gonzacarv/Casandra/README.md

Casandra v1.3 - v8.2 (CocinaBis + Huerta v2)
Casandra v1.1 - v8.1 (NewServer)
Casandra v1.0 - v7.1 (BoolDebug)
Casandra v1.0 - v6 (RGB Add - Botones)    
Casandra v1.0 - v4 (TreinBuff fix)   
Firmwares de domótica personal (MCU: 18F4620, 16F877A, 16F628, Atmega328, Atmega2560, ESP8266).
