gonzacarv/Casandra/Hard/Proyecto CASANDRA.docx

Proyecto CASANDRA

Mapa de pines I/O:

I01 → RC0

I02 → RC1

I03 → RC2

I04 → RC3

I05 → RD0

I06 → RD1

I07 → +Vcc

I08 → RD6

I09 → RD5

I10 → RD4

I11 → RC4

I12 → RD3

I13 → RD2

I14 → +Vcc

O01 → RB6

O02 → RB5

O03 → RB4

O04 → RB3

O05 → RB2

O06 → RB1

O07 → GND

O08 → RB7

O09 → RA0

O10 → RA1

O11 → RA2

O12 → RA3

O13 → RA4

O14 → GND
