gonzacarv/Casandra/Hard/Actuador Entrada - Salida/Casandra v1PCB.BMP

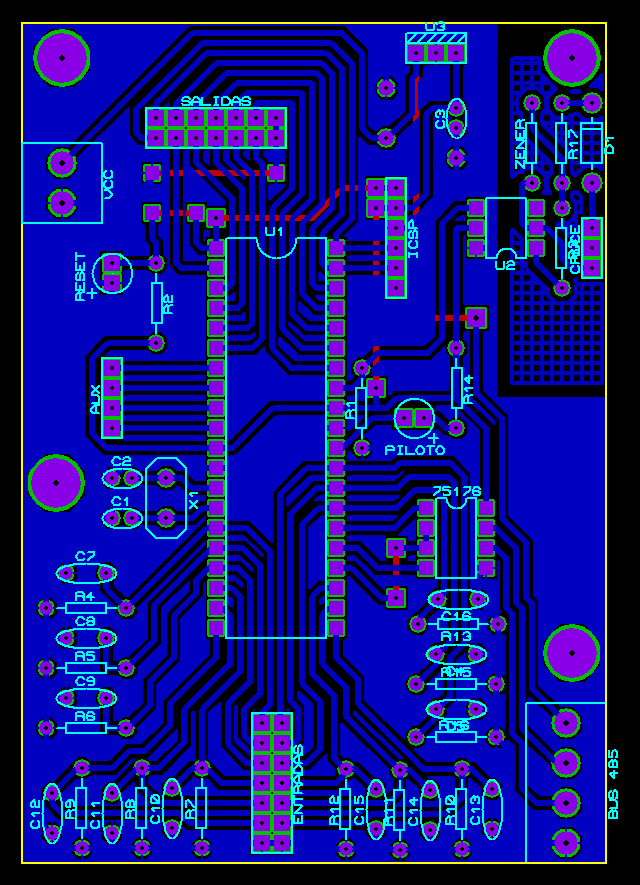
Hard/Actuador Entrada - Salida/Casandra v1PCB.BMP
