gonzacarv/Casandra/Hard/Actuador PotenciaPCB.BMP

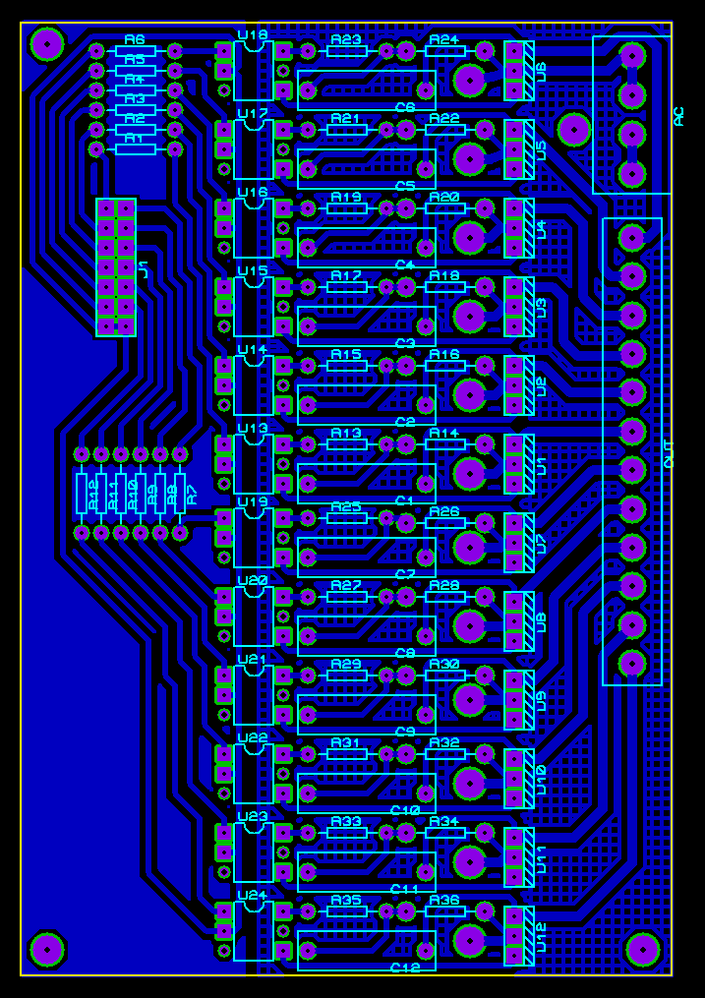
Hard/Actuador PotenciaPCB.BMP
