gonzacarv/Casandra/Hard/Entradas.BMP

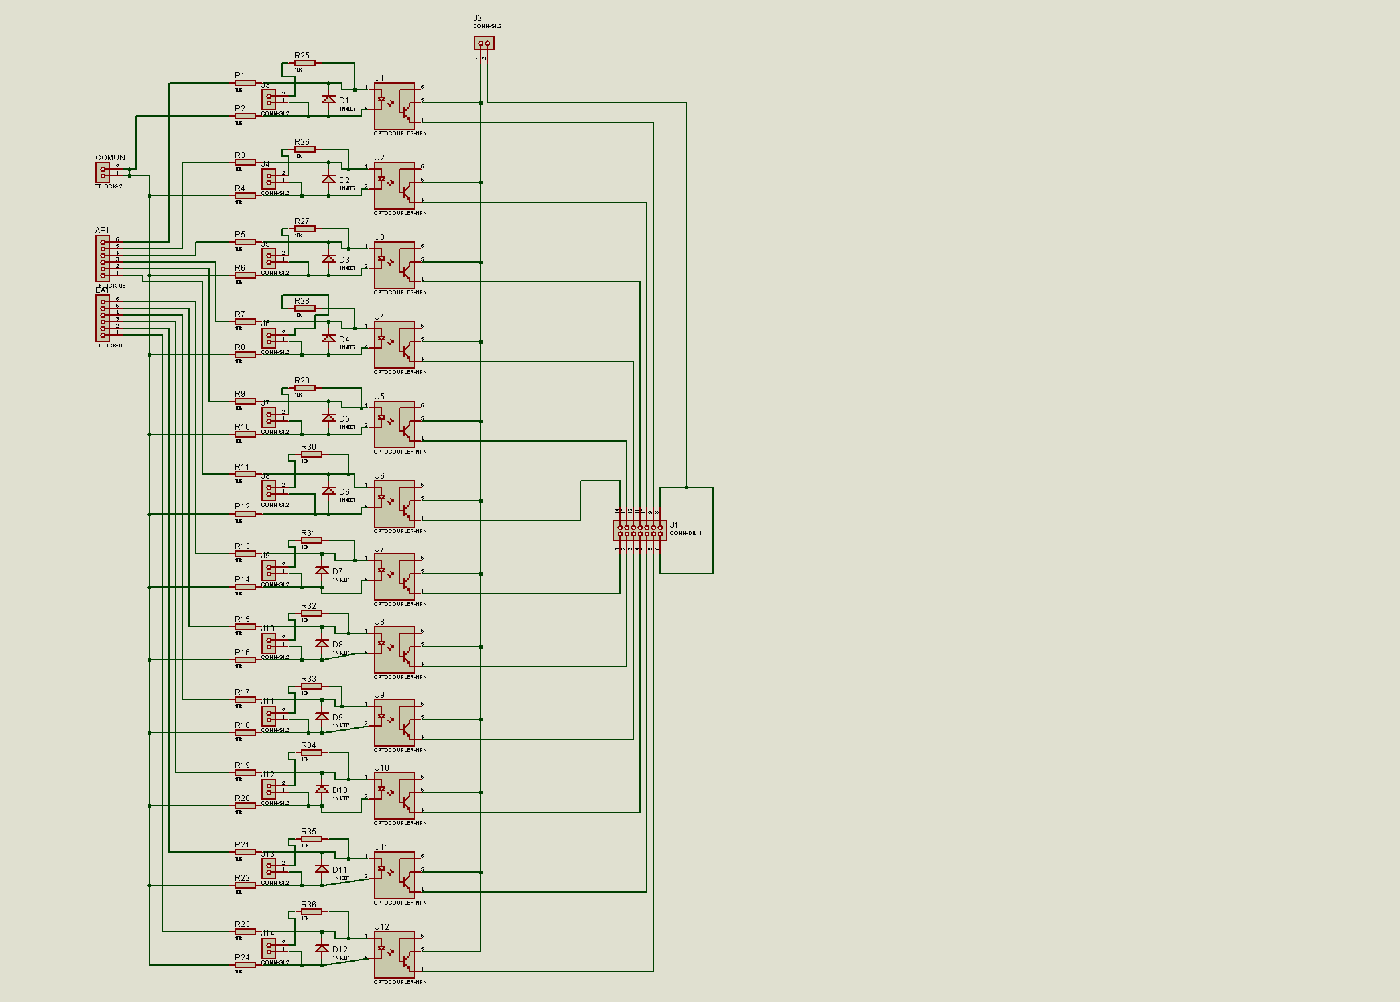
Hard/Entradas.BMP
