gonzacarv/Casandra/Hard/EntradasPCB.BMP

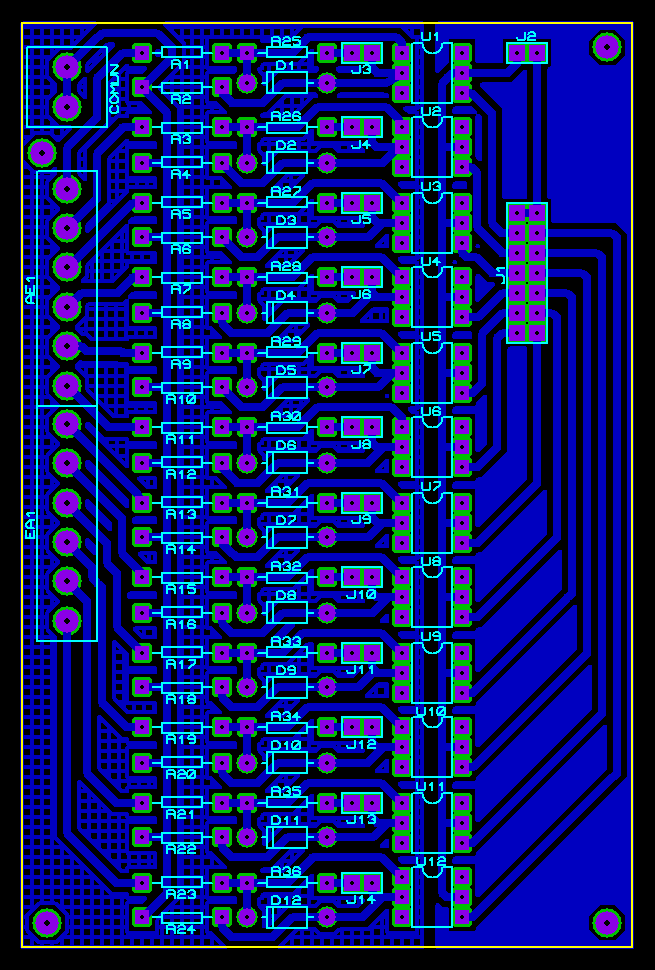
Hard/EntradasPCB.BMP
