gonzacarv/Casandra/Hard/Hardware/ENC28j60.png

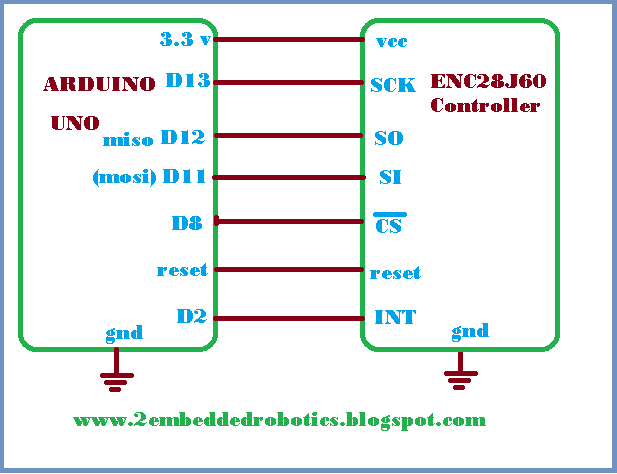
Hard/Hardware/ENC28j60.png
