gonzacarv/Casandra/Hard/Teclado/circuito.gif

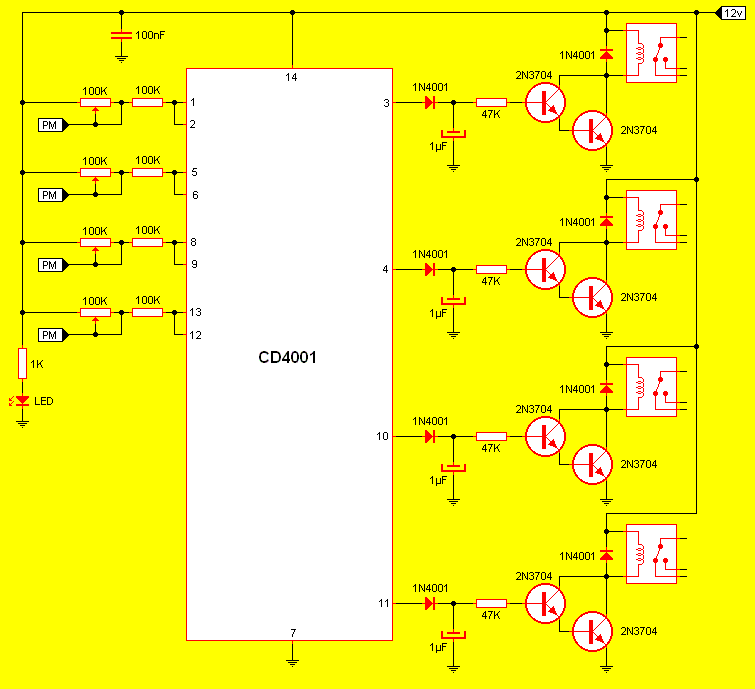
Hard/Teclado/circuito.gif
