gonzacarv/Casandra/Soft/Dimer.xlsx

Sheet: Comandos
 |  | Destinos |  |  | Comandos |  |  | COMANDOS EN RED
 |  | RED | LOCAL | checksum | Codigo | Descripcion |  | Byte (1): Ctrl | Byte (2): Destino |  | Byte (3): Comando |  | Byte (4): Checksum
 |  | 30 | ID |  | 27 | 10% |  |  | Valor | Descripcion | Valor | Descripcion
1 | 32 | 33 | 1 | 217 | 24 | 20% |  | 250 | 29 | PANICO | 29 | PANICO | Destino + Comando
2 |  | 34 | 2 | 216 | 21 | 30% |  | 250 | 33 a 93 | Luces individuales | 27 a 0 // 80 a 141 | Intensidad // Modos | Destino + Comando
3 |  | 35 | 3 | 215 | 18 | 40% |  | 250 | 100 | Todas las luces | 27 a 0 // 80 a 141 | Intensidad // Modos | Destino + Comando
4 |  | 36 | 4 | 214 | 15 | 50% |  | 250 | 150 | Webserver | 80: Off // 90: On | Off // On | Destino + Comando
5 |  | 37 | 5 | 213 | 12 | 60% |  | 250 | 151 | Telefonico | 80: Off // 90: On | Off // On | Destino + Comando
6 |  | 38 | 6 | 212 | 9 | 70% |  | 250 | 155 | Sirena | 0: Off // 1 ~ 99: Seg // 100: On | Off // Segundos // On | Destino + Comando
7 |  | 39 | 7 | 211 | 6 | 80% |  | 250 | 160 | Temperatura exterior | Codificado segun Programa | Ver codigo | Destino + Comando
8 |  | 40 | 8 | 210 | 3 | 90% |  | 250 | 165 | Intensidad del sol | Codificado segun Programa | Ver codigo | Destino + Comando
9 |  | 41 | 9 | 209 | 0 | 100% |  | 250 | 163 | Tension de bateria | Codificado segun Programa | Ver codigo | Destino + Comando
10 |  | 42 | 10 | 208 | … | … |  | 250 | 164 | Valor de jumper | Codificado segun Programa | Ver codigo | Destino + Comando
11 |  | 43 | 11 | 207 | 80 | Apagado |  | 250 | 184 | Identificacion de modulos | 49, 50, 51, 52 53 y 54 respectiv. | Mod 1 a 5 y mod exterior | Destino + Comando
12 |  | 44 | 12 | 206 | 90 | Encendido según int
13 | 44 | 45 | 1 | 205 | 102 | Encendido Fijo 1 | Max
14 |  | 46 | 2 | 204 | 95 | Encendido Fijo 2 | Med
15 |  | 47 | 3 | 203 | 96 | Encendido Fijo 3 | Bajo
16 |  | 48 | 4 | 202 | … | …
17 |  | 49 | 5 | 201 | 120 | ONOFF 2,56
18 |  | 50 | 6 | 200 | 121 | ONOFF 1,28
19 |  | 51 | 7 | 199 | 122 | ONOFF 0,64
20 |  | 52 | 8 | 198 | 123 | ONOFF 0,32
21 |  | 53 | 9 | 197 | … | …
22 |  | 54 | 10 | 196 | 130 | OLA 2,56
23 |  | 55 | 11 | 195 | 131 | OLA 1,28
24 |  | 56 | 12 | 194 | 132 | OLA 0,64
25 | 56 | 57 | 1 | 193 | … | …
26 |  | 58 | 2 | 192 | 140 | ALARMA ON 0,65
27 |  | 59 | 3 | 191 | 141 | ALARMA OFF
28 |  | 60 | 4 | 190
29 |  | 61 | 5 | 189
30 |  | 62 | 6 | 188 | ID's | 1: Cuartos 1
31 |  | 63 | 7 | 187 | ID's | 2: Cuartos 2
32 |  | 64 | 8 | 186 | ID's | 3: Cocina 1
33 |  | 65 | 9 | 185 | ID's | 4: Cocina 2
34 |  | 66 | 10 | 184 | ID's | 5: Galeria
35 |  | 67 | 11 | 183 | ID's | 6: Alarma
36 |  | 68 | 12 | 182 | ID's | 7: Web
37 | 68 | 69 | 1 | 181 | ID's | 8: Telefonico
38 |  | 70 | 2 | 180
39 |  | 71 | 3 | 179
40 |  | 72 | 4 | 178
41 |  | 73 | 5 | 177
42 |  | 74 | 6 | 176
43 |  | 75 | 7 | 175
44 |  | 76 | 8 | 174
45 |  | 77 | 9 | 173
46 |  | 78 | 10 | 172
47 |  | 79 | 11 | 171
48 |  | 80 | 12 | 170
49 | 80 | 81 | 1 | 169
50 |  | 82 | 2 | 168
51 |  | 83 | 3 | 167
52 |  | 84 | 4 | 166
53 |  | 85 | 5 | 165
54 |  | 86 | 6 | 164
55 |  | 87 | 7 | 163
56 |  | 88 | 8 | 162
57 |  | 89 | 9 | 161
58 |  | 90 | 10 | 160
59 |  | 91 | 11 | 159
60 |  | 92 | 12 | 158
 |  | 93 | Exterior | 157
 |  | 100 | TODOS
 |  | 150 | WEBServer | 80 | Apagado
 |  |  |  | 90 | Encendido
 |  | 151 | Telefonico | 80 | Apagado
 |  |  |  | 90 | Encendido
 |  | 155 | Sirena | TiempoSeg | 100 | ALARMA ON (sin teclas)
 |  |  |  |  | 0 | ALARMA OFF (recupera teclas)
 |  | 160 | TempOut | (se envia elevado +10 para evitar negativo en red)
 |  | 165 | LuzOut | (0 a 100 - no cumple checksum en 85%)
 |  | 163 | Vbat | x10 | y fuente
 |  | 164 | Jumper | (0 - 1)

Sheet: I-O
En MQTT | En RS485 | Salida PIC | Descripcion |  | Descripcion |  | IP | Mosquito
1 | 33 | 1 |  |  |  |  | 176 | Cuartos
2 | 34 | 2 | Luz Derecha Sofia |  | Interruptor Derecha Sofia |  | 71 | Cocina
3 | 35 | 3 | Luz Izquierda Sofia |  | Interruptor Izquierda Sofia |  | 128 | Galeria
4 | 36 | 4 | Luz principal Sofia |  | Interruptor principal Sofia |  | 76 | Caldera
5 | 37 | 5 |  |  |  |  | 77 | Hall
6 | 38 | 6 | Luz Izquierda Mama |  | Interruptor Izquierda Mama |  | 130 | Porton
7 | 39 | 7 | Luz Derecha Papa |  | Interruptor Derecha Papa |  | 146 | Estar
8 | 40 | 8 | Luz Vestidor Papa-Mama |  | Interruptor Vestidor Papa-Mama |  | 178 | CocinaBis
9 | 41 | 9 | Luz baño Papa-Mama |  | Interruptor baño Papa-Mama
10 | 42 | 10 | Luz Ante-baño Papa-Mama |  | Interruptor Ante-baño Papa-Mama
11 | 43 | 11 | Luz Perimetro |  | PANICO
12 | 44 | 12 | Luz Cuarto Papa-Mama |  | Interruptor Cuarto Papa-Mama
13 | 45 | 13 | Luz Ante-baño Sofia y Nico |  | Interruptor Ante-baño Sofia y Nico
14 | 46 | 14 | Luz Baño Sofia y Nico |  | Interruptor Baño Sofia y Nico
15 | 47 | 15 | Luz Pasillo Entrada/Estar |  | Interruptor Pasillo Entrada/Estar
16 | 48 | 16 | Luz Pasillo Cuartos |  | Interruptor Pasillo Cuartos
17 | 49 | 17 | Luz Cuarto Nico-Gon |  | Interruptor Cuarto Nico-Gon
18 | 50 | 18
19 | 51 | 19 | Luz Izquierda Nico |  | Interruptor Izquierda Nico
20 | 52 | 20 | Luz pasillito Cuarto Nico-Sofia |  | Interruptor pasillito Cuarto Nico-Sofia
21 | 53 | 21 | Luz Derecha Gon |  | Interruptor Derecha Gon
22 | 54 | 22
23 | 55 | 23
24 | 56 | 24 | Luz ventana del Hall |  | Interruptor ventana del Hall
1 | 57 | 25 | Luz Exterior entrada Principal
2 | 58 | 26 | Luz Hall | ok | Interruptor Hall | ok
3 | 59 | 27 |  |  | Hall | ok
4 | 60 | 28 |  |  | Sensor del Estar | ok
5 | 61 | 29 |  |  | Sensor de Cocina | ok
6 | 62 | 30 |  |  | Sensor del Living | ok
7 | 63 | 31 | Luz Central Cocina | ok | Interruptor Central Cocina | ok
8 | 64 | 32 | Luz Lavadero | ok | Interruptor Lavadero | ok
9 | 65 | 33 | Luz Estar | ok | Interruptor Estar | ok
10 | 66 | 34
11 | 67 | 35
12 | 68 | 36 | Luz Exterior Estar | ok | Interruptor Exterior Estar | ok
13 | 69 | 37
14 | 70 | 38 | Luz Living | ok | Interruptor living | ok
15 | 71 | 39
16 | 72 | 40 | Ventilador Estar
17 | 73 | 41 |  |  | Sensor del Pasillo del Lavadero | ok | IP | Mosquito
18 | 74 | 42 |  |  | Sensor del Garage | ok | 62 | Cuartos
19 | 75 | 43 | Luz Garage |  | Interruptor Garage | ok | 71 | Cocina
20 | 76 | 44 | Luz Pasillo Lavadero | ok | Interruptor Pasillo Lavadero | ok | 128 | Galeria
21 | 77 | 45 | Luz Toilette | ok | Interruptor Toilette | ok | 76 | Caldera
22 | 78 | 46 |  |  |  |  | 77 | Hall
23 | 79 | 47 |  |  |  |  | 130 | Porton
24 | 80 | 48 |  |  | Interruptor Comedor | ok | 146 | Estar
1 | 81 | 49 | Luz parrilla |  | Interruptor lado parrilla
2 | 82 | 50 | Luz zona parrilla |  | Interruptor C4
3 | 83 | 51 | Luz pared Galeria |  | Interruptor C1
4 | 84 | 52 | Luz Principal Galeria |  | Interruptor C3
5 | 85 | 53 | Ventilador Galeria |  | Interruptor C2
6 | 86 | 54 | Guirnalda Galeria
7 | 87 | 55
8 | 88 | 56 | Led Cobertizo
9 | 89 | 57
10 | 90 | 58
11 | 91 | 59 |  |  | Sensor de la Galeria
12 | 92 | 60 |  |  | Sensor de la Parrilla
1 | NA | 61 | Luz de sodio del jardin

Sheet: Red MQTT
N0 | N1 | N2 | N3 | Rango Payload | Descripcion | Ejecutor | Topic completo
Casandra | Cuartos | LuzEstado | 01 | 0 o 1 | Estado de encendido de luz | PIC | Casandra/Cuartos/LuzEstado/01
Casandra | Cuartos | LuzEstado | 02 | 0 o 1 | Estado de encendido de luz | PIC | Casandra/Cuartos/LuzEstado/02
Casandra | Cuartos | LuzEstado | 03 | 0 o 1 | Estado de encendido de luz | PIC | Casandra/Cuartos/LuzEstado/03
Casandra | Cuartos | LuzEstado | 04 | 0 o 1 | Estado de encendido de luz | PIC | Casandra/Cuartos/LuzEstado/04
Casandra | Cuartos | LuzEstado | 05 | 0 o 1 | Estado de encendido de luz | PIC | Casandra/Cuartos/LuzEstado/05
Casandra | Cuartos | LuzEstado | 06 | 0 o 1 | Estado de encendido de luz | PIC | Casandra/Cuartos/LuzEstado/06
Casandra | Cuartos | LuzEstado | 07 | 0 o 1 | Estado de encendido de luz | PIC | Casandra/Cuartos/LuzEstado/07
Casandra | Cuartos | LuzEstado | 08 | 0 o 1 | Estado de encendido de luz | PIC | Casandra/Cuartos/LuzEstado/08
Casandra | Cuartos | LuzEstado | 09 | 0 o 1 | Estado de encendido de luz | PIC | Casandra/Cuartos/LuzEstado/09
Casandra | Cuartos | LuzEstado | 10 | 0 o 1 | Estado de encendido de luz | PIC | Casandra/Cuartos/LuzEstado/10
Casandra | Cuartos | LuzEstado | 11 | 0 o 1 | Estado de encendido de luz | PIC | Casandra/Cuartos/LuzEstado/11
Casandra | Cuartos | LuzEstado | 12 | 0 o 1 | Estado de encendido de luz | PIC | Casandra/Cuartos/LuzEstado/12
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
Casandra | Cuartos | Temperatura | 01 | SignedInt | Temperatura en °C | NodeMCU | Casandra/Cuartos/Temperatura/01
Casandra | Cuartos | Temperatura | 02 | SignedInt | Temperatura en °C | NodeMCU | Casandra/Cuartos/Temperatura/02
Casandra | Cuartos | Humedad | 01 | SignedInt | Humedad porcentual | NodeMCU | Casandra/Cuartos/Humedad/01
Casandra | Cuartos | Humedad | 02 | SignedInt | Humedad porcentual | NodeMCU | Casandra/Cuartos/Humedad/02
Casandra | Cuartos | SensorMov | 01 | 0 o 1 | Estado de sensor de movimiento | NodeMCU | Casandra/Cuartos/SensorMov/01
Casandra | Cuartos | SensorMov | 02 | 1 o 1 | Estado de sensor de movimiento | NodeMCU | Casandra/Cuartos/SensorMov/02
Casandra | Cuartos | Mosquito |  | Reset / Reconect / Exec | Estado de reset del Mosquito Cuartos | NodeMCU | Casandra/Cuartos/Mosquito
Casandra | Cuartos | Modulo | 1 | on o off | Estado de reset del modulo | PIC | Casandra/Cuartos/Modulo/1
Casandra | Cuartos | Modulo | 2 | on o off | Estado de reset del modulo | PIC | Casandra/Cuartos/Modulo/2
Casandra | Cocina | LuzEstado | 01 | 0 o 1 | Estado de encendido de luz | PIC | Casandra/Cocina/LuzEstado/01
Casandra | Cocina | LuzEstado | 02 | 0 o 1 | Estado de encendido de luz | PIC | Casandra/Cocina/LuzEstado/02
Casandra | Cocina | LuzEstado | 03 | 0 o 1 | Estado de encendido de luz | PIC | Casandra/Cocina/LuzEstado/03
Casandra | Cocina | LuzEstado | 04 | 0 o 1 | Estado de encendido de luz | PIC | Casandra/Cocina/LuzEstado/04
Casandra | Cocina | LuzEstado | 05 | 0 o 1 | Estado de encendido de luz | PIC | Casandra/Cocina/LuzEstado/05
Casandra | Cocina | LuzEstado | 06 | 0 o 1 | Estado de encendido de luz | PIC | Casandra/Cocina/LuzEstado/06
Casandra | Cocina | LuzEstado | 07 | 0 o 1 | Estado de encendido de luz | PIC | Casandra/Cocina/LuzEstado/07
Casandra | Cocina | LuzEstado | 08 | 0 o 1 | Estado de encendido de luz | PIC | Casandra/Cocina/LuzEstado/08
Casandra | Cocina | LuzEstado | 09 | 0 o 1 | Estado de encendido de luz | PIC | Casandra/Cocina/LuzEstado/09
Casandra | Cocina | LuzEstado | 10 | 0 o 1 | Estado de encendido de luz | PIC | Casandra/Cocina/LuzEstado/10
Casandra | Cocina | LuzEstado | 11 | 0 o 1 | Estado de encendido de luz | PIC | Casandra/Cocina/LuzEstado/11
Casandra | Cocina | LuzEstado | 12 | 0 o 1 | Estado de encendido de luz | PIC | Casandra/Cocina/LuzEstado/12
Casandra | Cocina | LuzEstado | 13 | 0 o 1 | Estado de encendido de luz | PIC | Casandra/Cocina/LuzEstado/13
Casandra | Cocina | LuzEstado | 14 | 0 o 1 | Estado de encendido de luz | PIC | Casandra/Cocina/LuzEstado/14
Casandra | Cocina | LuzEstado | 15 | 0 o 1 | Estado de encendido de luz | PIC | Casandra/Cocina/LuzEstado/15
Casandra | Cocina | LuzEstado | 16 | 0 o 1 | Estado de encendido de luz | PIC | Casandra/Cocina/LuzEstado/16
Casandra | Cocina | LuzEstado | 17 | 0 o 1 | Estado de encendido de luz | PIC | Casandra/Cocina/LuzEstado/17
Casandra | Cocina | LuzEstado | 18 | 0 o 1 | Estado de encendido de luz | PIC | Casandra/Cocina/LuzEstado/18
Casandra | Cocina | LuzEstado | 19 | 0 o 1 | Estado de encendido de luz | PIC | Casandra/Cocina/LuzEstado/19
Casandra | Cocina | LuzEstado | 20 | 0 o 1 | Estado de encendido de luz | PIC | Casandra/Cocina/LuzEstado/20
Casandra | Cocina | LuzEstado | 21 | 0 o 1 | Estado de encendido de luz | PIC | Casandra/Cocina/LuzEstado/21
Casandra | Cocina | LuzEstado | 22 | 0 o 1 | Estado de encendido de luz | PIC | Casandra/Cocina/LuzEstado/22
Casandra | Cocina | LuzEstado | 23 | 0 o 1 | Estado de encendido de luz | PIC | Casandra/Cocina/LuzEstado/23
Casandra | Cocina | LuzEstado | 24 | 0 o 1 | Estado de encendido de luz | PIC | Casandra/Cocina/LuzEstado/24
Casandra | Cocina | LuzEstado | 25 | 0 o 1 | Estado de encendido de luz | NodeMCU | Casandra/Cocina/LuzEstado/25
Casandra | Cocina | LuzEstado | 26 | 0 o 1 | Estado de encendido de luz | NodeMCU | Casandra/Cocina/LuzEstado/26
Casandra | Cocina | LuzIntensidad | 01 | 0 a 100 | Intensidad de encendido de luz | PIC | Casandra/Cocina/LuzIntensidad/01
Casandra | Cocina | LuzIntensidad | 02 | 0 a 100 | Intensidad de encendido de luz | PIC | Casandra/Cocina/LuzIntensidad/02
Casandra | Cocina | LuzIntensidad | 03 | 0 a 100 | Intensidad de encendido de luz | PIC | Casandra/Cocina/LuzIntensidad/03
Casandra | Cocina | LuzIntensidad | 04 | 0 a 100 | Intensidad de encendido de luz | PIC | Casandra/Cocina/LuzIntensidad/04
Casandra | Cocina | LuzIntensidad | 05 | 0 a 100 | Intensidad de encendido de luz | PIC | Casandra/Cocina/LuzIntensidad/05
Casandra | Cocina | LuzIntensidad | 06 | 0 a 100 | Intensidad de encendido de luz | PIC | Casandra/Cocina/LuzIntensidad/06
Casandra | Cocina | LuzIntensidad | 07 | 0 a 100 | Intensidad de encendido de luz | PIC | Casandra/Cocina/LuzIntensidad/07
Casandra | Cocina | LuzIntensidad | 08 | 0 a 100 | Intensidad de encendido de luz | PIC | Casandra/Cocina/LuzIntensidad/08
Casandra | Cocina | LuzIntensidad | 09 | 0 a 100 | Intensidad de encendido de luz | PIC | Casandra/Cocina/LuzIntensidad/09
Casandra | Cocina | LuzIntensidad | 10 | 0 a 100 | Intensidad de encendido de luz | PIC | Casandra/Cocina/LuzIntensidad/10
Casandra | Cocina | LuzIntensidad | 11 | 0 a 100 | Intensidad de encendido de luz | PIC | Casandra/Cocina/LuzIntensidad/11
Casandra | Cocina | LuzIntensidad | 12 | 0 a 100 | Intensidad de encendido de luz | PIC | Casandra/Cocina/LuzIntensidad/12
Casandra | Cocina | LuzIntensidad | 13 | 0 a 100 | Intensidad de encendido de luz | PIC | Casandra/Cocina/LuzIntensidad/13
Casandra | Cocina | LuzIntensidad | 14 | 0 a 100 | Intensidad de encendido de luz | PIC | Casandra/Cocina/LuzIntensidad/14
Casandra | Cocina | LuzIntensidad | 15 | 0 a 100 | Intensidad de encendido de luz | PIC | Casandra/Cocina/LuzIntensidad/15
Casandra | Cocina | LuzIntensidad | 16 | 0 a 100 | Intensidad de encendido de luz | PIC | Casandra/Cocina/LuzIntensidad/16
Casandra | Cocina | LuzIntensidad | 17 | 0 a 100 | Intensidad de encendido de luz | PIC | Casandra/Cocina/LuzIntensidad/17
Casandra | Cocina | LuzIntensidad | 18 | 0 a 100 | Intensidad de encendido de luz | PIC | Casandra/Cocina/LuzIntensidad/18
Casandra | Cocina | LuzIntensidad | 19 | 0 a 100 | Intensidad de encendido de luz | PIC | Casandra/Cocina/LuzIntensidad/19
Casandra | Cocina | LuzIntensidad | 20 | 0 a 100 | Intensidad de encendido de luz | PIC | Casandra/Cocina/LuzIntensidad/20
Casandra | Cocina | LuzIntensidad | 21 | 0 a 100 | Intensidad de encendido de luz | PIC | Casandra/Cocina/LuzIntensidad/21
Casandra | Cocina | LuzIntensidad | 22 | 0 a 100 | Intensidad de encendido de luz | PIC | Casandra/Cocina/LuzIntensidad/22
Casandra | Cocina | LuzIntensidad | 23 | 0 a 100 | Intensidad de encendido de luz | PIC | Casandra/Cocina/LuzIntensidad/23
Casandra | Cocina | LuzIntensidad | 24 | 0 a 100 | Intensidad de encendido de luz | PIC | Casandra/Cocina/LuzIntensidad/24
Casandra | Cocina | Temperatura | 01 | SignedInt | Temperatura en °C | NodeMCU | Casandra/Cocina/Temperatura/01
Casandra | Cocina | Temperatura | 02 | SignedInt | Temperatura en °C | NodeMCU | Casandra/Cocina/Temperatura/02
Casandra | Cocina | Humedad | 01 | SignedInt | Humedad porcentual | NodeMCU | Casandra/Cocina/Humedad/01
Casandra | Cocina | Humedad | 02 | SignedInt | Humedad porcentual | NodeMCU | Casandra/Cocina/Humedad/02
Casandra | Cocina | SensorMov | 01 | 0 o 1 | Estado de sensor de movimiento | NodeMCU | Casandra/Cocina/SensorMov/01
Casandra | Cocina | SensorMov | 02 | 0 o 1 | Estado de sensor de movimiento | NodeMCU | Casandra/Cocina/SensorMov/02
Casandra | Cocina | SensorMov | 03 | 0 o 1 | Estado de sensor de movimiento | NodeMCU | Casandra/Cocina/SensorMov/03
Casandra | Cocina | SensorMov | 04 | 0 o 1 | Estado de sensor de movimiento | NodeMCU | Casandra/Cocina/SensorMov/04
Casandra | Cocina | SensorMov | 05 | 0 o 1 | Estado de sensor de movimiento | NodeMCU | Casandra/Cocina/SensorMov/05
Casandra | Cocina | SensorMov | 06 | 0 o 1 | Estado de sensor de movimiento | NodeMCU | Casandra/Cocina/SensorMov/06
Casandra | Cocina | Mosquito |  | Reset / Reconect / Exec | Estado de reset del Mosquito Cocina | NodeMCU | Casandra/Cocina/Mosquito
Casandra | Cocina | Modulo | 1 | on o off | Estado de reset del modulo | PIC | Casandra/Cocina/Modulo/1
Casandra | Cocina | Modulo | 2 | on o off | Estado de reset del modulo | PIC | Casandra/Cocina/Modulo/2
Casandra | Galeria | LuzEstado | 01 | 0 o 1 | Estado de encendido de luz | PIC | Casandra/Galeria/LuzEstado/01
Casandra | Galeria | LuzEstado | 02 | 0 o 1 | Estado de encendido de luz | PIC | Casandra/Galeria/LuzEstado/02
Casandra | Galeria | LuzEstado | 03 | 0 o 1 | Estado de encendido de luz | PIC | Casandra/Galeria/LuzEstado/03
Casandra | Galeria | LuzEstado | 04 | 0 o 1 | Estado de encendido de luz | PIC | Casandra/Galeria/LuzEstado/04
Casandra | Galeria | LuzEstado | 05 | 0 o 1 | Estado de encendido de luz | PIC | Casandra/Galeria/LuzEstado/05
Casandra | Galeria | LuzEstado | 06 | 0 o 1 | Estado de encendido de luz | PIC | Casandra/Galeria/LuzEstado/06
Casandra | Galeria | LuzEstado | 07 | 0 o 1 | Estado de encendido de luz | PIC | Casandra/Galeria/LuzEstado/07
Casandra | Galeria | LuzEstado | 08 | 0 o 1 | Estado de encendido de luz | PIC | Casandra/Galeria/LuzEstado/08
Casandra | Galeria | LuzEstado | 09 | 0 o 1 | Estado de encendido de luz | PIC | Casandra/Galeria/LuzEstado/09
Casandra | Galeria | LuzEstado | 10 | 0 o 1 | Estado de encendido de luz | PIC | Casandra/Galeria/LuzEstado/10
Casandra | Galeria | LuzEstado | 11 | 0 o 1 | Estado de encendido de luz | PIC | Casandra/Galeria/LuzEstado/11
Casandra | Galeria | LuzEstado | 12 | 0 o 1 | Estado de encendido de luz | PIC | Casandra/Galeria/LuzEstado/12
Casandra | Galeria | LuzIntensidad | 01 | 0 a 100 | Intensidad de encendido de luz | PIC | Casandra/Galeria/LuzIntensidad/01
Casandra | Galeria | LuzIntensidad | 02 | 0 a 100 | Intensidad de encendido de luz | PIC | Casandra/Galeria/LuzIntensidad/02
Casandra | Galeria | LuzIntensidad | 03 | 0 a 100 | Intensidad de encendido de luz | PIC | Casandra/Galeria/LuzIntensidad/03
Casandra | Galeria | LuzIntensidad | 04 | 0 a 100 | Intensidad de encendido de luz | PIC | Casandra/Galeria/LuzIntensidad/04
Casandra | Galeria | LuzIntensidad | 05 | 0 a 100 | Intensidad de encendido de luz | PIC | Casandra/Galeria/LuzIntensidad/05
Casandra | Galeria | LuzIntensidad | 06 | 0 a 100 | Intensidad de encendido de luz | PIC | Casandra/Galeria/LuzIntensidad/06
Casandra | Galeria | LuzIntensidad | 07 | 0 a 100 | Intensidad de encendido de luz | PIC | Casandra/Galeria/LuzIntensidad/07
Casandra | Galeria | LuzIntensidad | 08 | 0 a 100 | Intensidad de encendido de luz | PIC | Casandra/Galeria/LuzIntensidad/08
Casandra | Galeria | LuzIntensidad | 09 | 0 a 100 | Intensidad de encendido de luz | PIC | Casandra/Galeria/LuzIntensidad/09
Casandra | Galeria | LuzIntensidad | 10 | 0 a 100 | Intensidad de encendido de luz | PIC | Casandra/Galeria/LuzIntensidad/10
Casandra | Galeria | LuzIntensidad | 11 | 0 a 100 | Intensidad de encendido de luz | PIC | Casandra/Galeria/LuzIntensidad/11
Casandra | Galeria | LuzIntensidad | 12 | 0 a 100 | Intensidad de encendido de luz | PIC | Casandra/Galeria/LuzIntensidad/12
Casandra | Galeria | Temperatura | 01 | SignedInt | Temperatura en °C | NodeMCU | Casandra/Galeria/Temperatura/01
Casandra | Galeria | Temperatura | 02 | SignedInt | Temperatura en °C | NodeMCU | Casandra/Galeria/Temperatura/02
Casandra | Galeria | Humedad | 01 | SignedInt | Humedad porcentual | NodeMCU | Casandra/Galeria/Humedad/01
Casandra | Galeria | Humedad | 02 | SignedInt | Humedad porcentual | NodeMCU | Casandra/Galeria/Humedad/02
Casandra | Galeria | SensorMov | 01 | 0 o 1 | Estado de sensor de movimiento | NodeMCU | Casandra/Galeria/SensorMov/01
Casandra | Galeria | SensorMov | 02 | 1 o 1 | Estado de sensor de movimiento | NodeMCU | Casandra/Galeria/SensorMov/02
Casandra | Galeria | Mosquito |  | Reset / Reconect / Exec | Estado de reset del Mosquito Galeria | NodeMCU | Casandra/Galeria/Mosquito
Casandra | Galeria | Modulo | 1 | on o off | Estado de reset del modulo | PIC | Casandra/Galeria/Modulo/1
Casandra | Hall | Sodios |  | 0 o 1 | Estado de encendido de Sodios | NodeMCU | Casandra/Hall/Sodios
Casandra | Hall | Sirena |  | 0 a 5 | X:0000 ; 1:1111 ; 2:1000 ; 3:1010 ; 4:1100 ; 5:0111 | NodeMCU | Casandra/Hall/Sirena
Casandra | Hall | LuzCamino |  | 0 o 1 | Estado de encendido de Luz del camino de entrada | NodeMCU | Casandra/Hall/LuzCamino
Casandra | Hall | LuzEntrada |  | 0 o 1 | Estado de encendido de Luz entrada | NodeMCU | Casandra/Hall/LuzEntrada
Casandra | Hall | Porton |  | 0 o 1 o 2 | Estado del porton | NodeMCU | Casandra/Hall/Porton
Casandra | Hall | Timbre |  | 0 o 1 | Estado del pulsador del timbre | NodeMCU | Casandra/Hall/Timbre
Casandra | Hall | Mosquito |  | Reset / Reconect / Exec | Estado de reset del Mosquito Hall | NodeMCU | Casandra/Hall/Mosquito
Casandra | Caldera | LuzSolar |  | UnsignedInt | Intensidad porcentual del sol | NodeMCU | Casandra/Caldera/LuzSolar
Casandra | Caldera | Lluvia |  | 0 o 1 | Sensor de lluvia | NodeMCU | Casandra/Caldera/Lluvia
Casandra | Caldera | Temperatura |  | SignedInt | Temperatura en °C | NodeMCU | Casandra/Caldera/Temperatura
Casandra | Caldera | LuzEstado | 01 | 0 o 1 | Estado de encendido de luz | NodeMCU | Casandra/Caldera/LuzEstado/01
Casandra | Caldera | LuzEstado | 02 | 0 o 1 | Estado de encendido de luz | NodeMCU | Casandra/Caldera/LuzEstado/02
Casandra | Caldera | LuzEstado | 03 | 0 o 1 | Estado de encendido de luz | NodeMCU | Casandra/Caldera/LuzEstado/03
Casandra | Caldera | Termostato |  | 0 o 1 | Estado de encendido del termostato | NodeMCU | Casandra/Caldera/Termostato
Casandra | Caldera | SensorMov | 01 | 0 o 1 | Estado de sensor de movimiento | NodeMCU | Casandra/Caldera/SensorMov/01
Casandra | Caldera | SensorMov | 02 | 0 o 1 | Estado de sensor de movimiento | NodeMCU | Casandra/Caldera/SensorMov/02
Casandra | Caldera | Mosquito |  | Reset / Reconect / Exec | Estado de reset del Mosquito Caldera | NodeMCU | Casandra/Caldera/Mosquito
Casandra | Porton | BtnAbrir |  | "PRESS" | Se enciende por 250ms y se apaga solo (BC548) | NodeMCU | Casandra/Porton/BtnAbrir
Casandra | Porton | BtnCerrar |  | "PRESS" | Se enciende por 250ms y se apaga solo (BC548) | NodeMCU | Casandra/Porton/BtnCerrar
Casandra | Porton | LuzCamino |  | 0 o 1 | Activa Relé | NodeMCU | Casandra/Porton/LuzCamino
Casandra | Porton | Timbre |  | 0 o 1 | Sensor de timbre | NodeMCU | Casandra/Porton/Timbre
Casandra | Porton | SensPuerta |  | 0 o 1 | Sensor de puerta | NodeMCU | Casandra/Porton/SensPuerta
Casandra | Porton | SensPorton |  | 0 o 1 | Sensor de porton | NodeMCU | Casandra/Porton/SensPorton
Casandra | Porton | Mosquito |  | Reset / Reconect / Exec | Estado de reset del Mosquito Porton | NodeMCU | Casandra/Porton/Mosquito
Casandra | Estar | LuzRGB |  | byte1,byte2,byte3 | Colores de 0 a 255 secuencia R-G-B | NodeMCU | Casandra/Estar/LuzRGB
Casandra | Estar | LuzEstado |  | 0 o 1 | Estado de encendido de luz | NodeMCU | Casandra/Estar/LuzEstado
Casandra | Estar | ModoLED |  | 1, 2, 3. 4 y 5 | "Normal", "OlaRGB", "FlashRGB". "Respira", "Flash" | NodeMCU | Casandra/Estar/ModoLED
Casandra | Estar | VelocidadLED |  | 0 a 10 | Velocidad del modo de encendido | NodeMCU | Casandra/Estar/VelocidadLED
Casandra | Estar | LuzIntensidad |  | 0 a 100 | Intensidad de encendido de luz | NodeMCU | Casandra/Estar/LuzIntensidad
Casandra | Estar | Temperatura |  | SignedInt | Temperatura en °C | NodeMCU | Casandra/Estar/Temperatura
Casandra | Estar | Humedad |  | SignedInt | Humedad porcentual | NodeMCU | Casandra/Estar/Humedad
Casandra | Estar | Termostato |  | 0 o 1 | Estado de encendido del termostato | NodeMCU | Casandra/Estar/Termostato
Casandra | Estar | CRemoto | BtnOnTV | "PRESS" | Boton de encendido de TV | NodeMCU | Casandra/Estar/CRemoto/BtnOnTV
Casandra | Estar | CRemoto | BtnOnDeco | "PRESS" | Boton de encendido de Deco | NodeMCU | Casandra/Estar/CRemoto/BtnOnDeco
Casandra | Estar | CRemoto | BtnCanalUpDeco | "PRESS" | Subir canal Deco | NodeMCU | Casandra/Estar/CRemoto/BtnCanalUpDeco
Casandra | Estar | CRemoto | BtnCanalDoDeco | "PRESS" | Bajar canal Deco | NodeMCU | Casandra/Estar/CRemoto/BtnCanalDoDeco
Casandra | Estar | CRemoto | BtnVolUpDeco | "PRESS" | Subir volumen Deco | NodeMCU | Casandra/Estar/CRemoto/BtnVolUpDeco
Casandra | Estar | CRemoto | BtnVolDoDeco | "PRESS" | Bajar volumen Deco | NodeMCU | Casandra/Estar/CRemoto/BtnVolDoDeco
Casandra | Estar | CRemoto | DecoBtn0 | "PRESS" | Boton 0 deco Express | NodeMCU | Casandra/Estar/CRemoto/DecoBtn0
Casandra | Estar | CRemoto | DecoBtn1 | "PRESS" | Boton 1 deco Express | NodeMCU | Casandra/Estar/CRemoto/DecoBtn1
Casandra | Estar | CRemoto | DecoBtn2 | "PRESS" | Boton 2 deco Express | NodeMCU | Casandra/Estar/CRemoto/DecoBtn2
Casandra | Estar | CRemoto | DecoBtn3 | "PRESS" | Boton 3 deco Express | NodeMCU | Casandra/Estar/CRemoto/DecoBtn3
Casandra | Estar | CRemoto | DecoBtn4 | "PRESS" | Boton 4 deco Express | NodeMCU | Casandra/Estar/CRemoto/DecoBtn4
Casandra | Estar | CRemoto | DecoBtn5 | "PRESS" | Boton 5 deco Express | NodeMCU | Casandra/Estar/CRemoto/DecoBtn5
Casandra | Estar | CRemoto | DecoBtn6 | "PRESS" | Boton 6 deco Express | NodeMCU | Casandra/Estar/CRemoto/DecoBtn6
Casandra | Estar | CRemoto | DecoBtn7 | "PRESS" | Boton 7 deco Express | NodeMCU | Casandra/Estar/CRemoto/DecoBtn7
Casandra | Estar | CRemoto | DecoBtn8 | "PRESS" | Boton 8 deco Express | NodeMCU | Casandra/Estar/CRemoto/DecoBtn8
Casandra | Estar | CRemoto | DecoBtn9 | "PRESS" | Boton 9 deco Express | NodeMCU | Casandra/Estar/CRemoto/DecoBtn9
Casandra | Estar | CRemoto | DecoBtnOk | "PRESS" | Boton OK deco Express | NodeMCU | Casandra/Estar/CRemoto/DecoBtnOk
Casandra | Estar | CRemoto | DecoBtnUp | "PRESS" | Boton Arriba deco Express | NodeMCU | Casandra/Estar/CRemoto/DecoBtnUp
Casandra | Estar | CRemoto | DecoBtnDw | "PRESS" | Boton Abajo deco Express | NodeMCU | Casandra/Estar/CRemoto/DecoBtnDw
Casandra | Estar | CRemoto | DecoBtnDe | "PRESS" | Boton Derecha deco Express | NodeMCU | Casandra/Estar/CRemoto/DecoBtnDe
Casandra | Estar | CRemoto | DecoBtnIz | "PRESS" | Boton Izquierda deco Express | NodeMCU | Casandra/Estar/CRemoto/DecoBtnIz
Casandra | Estar | CRemoto | DecoBtnMute | "PRESS" | Boton Mute deco Express | NodeMCU | Casandra/Estar/CRemoto/DecoBtnMute
Casandra | Estar | CRemoto | DecoBtnGuide | "PRESS" | Boton Guide deco Express | NodeMCU | Casandra/Estar/CRemoto/DecoBtnGuide
Casandra | Estar | CRemoto | DecoBtnExit | "PRESS" | Boton Exit deco Express | NodeMCU | Casandra/Estar/CRemoto/DecoBtnExit
Casandra | Estar | AA | Fan | String | [“auto”, “low”, “medium”, “high”] | NodeMCU | Casandra/Estar/AA/Fan
Casandra | Estar | AA | Modo | String | [“auto”, “off”, “cool”, “heat”, “dry”, “fan_only”] | NodeMCU | Casandra/Estar/AA/Modo
Casandra | Estar | AA | Swing | String | [“on”, “off”] | NodeMCU | Casandra/Estar/AA/Swing
Casandra | Estar | AA | TempObj | 16 a 30 | Temperatura objetivo del aire | NodeMCU | Casandra/Estar/AA/TempObj
Casandra | Estar | Mosquito |  | Reset / Reconect / Exec | Estado de reset del Mosquito Estar | NodeMCU | Casandra/Estar/Mosquito
Casandra | Huerta | On |  | 3 a 5000 seg | Tiempo de prendido | NodeMCU | Casandra/Huerta/On
Casandra | Huerta | Off |  | 3 a 5000 seg | Tiempo de apagado | NodeMCU | Casandra/Huerta/Off
Casandra | Huerta | Bomba |  | 0 o 1 | Sensor de encendido de la bomba | NodeMCU | Casandra/Huerta/Bomba
Casandra | Huerta | BbaEstado |  | 0 o 1 | Comando de encendido de la bomba | NodeMCU | Casandra/Huerta/BbaEstado
Casandra | Huerta | Mosquito |  | Reset / Reconect / Exec | Estado de reset del Mosquito Huerta | NodeMCU | Casandra/Huerta/Mosquito
Casandra | CocinaBis | LEDMesadaEst |  | 0 o 1 | Estado de encendido de luz LED | NodeMCU | Casandra/CocinaBis/LEDMesadaEst
Casandra | CocinaBis | LEDMesadaInt |  | 0 a 100 | Intensidad de encendido de luz LED | NodeMCU | Casandra/CocinaBis/LEDMesadaInt
Casandra | CocinaBis | ModoLED |  | 1, 2 y 3 | "Normal", "Respira", "Flash" | NodeMCU | Casandra/CocinaBis/ModoLED
Casandra | CocinaBis | VelocidadLED |  | 0 a 100 | Velocidad del modo de encendido | NodeMCU | Casandra/CocinaBis/VelocidadLED
Casandra | CocinaBis | SWPorton |  | 0 o 1 | Estado de Switch Porton | NodeMCU | Casandra/CocinaBis/SWPorton
Casandra | CocinaBis | LuzEntrada |  | 0 o 1 | Estado de encendido de Luz entrada | NodeMCU | Casandra/CocinaBis/LuzEntrada
Casandra | CocinaBis | Mosquito |  | Reset / Reconect / Exec | Estado de reset del Mosquito CocinaBis | NodeMCU | Casandra/CocinaBis/Mosquito

Sheet: Sensor Luz v3
Valor Raw | F1 | F2 | F3 |  |  |  |  |  | Luz Intens | F1 | F2 |  |  |  |  | Luz Intens | F1 | F2 |  | x | y
0 | 0.0 |  |  |  | Elec | MQTT |  |  | 0 | -200 | 0 |  | Elec | MQTT |  | 0 | 0 | 23 | p1 | 200 | 50
10 | 3.3 |  |  |  | 700 | 50 |  |  | 10 | -197.06 | 0.59 |  | 0 | 0 |  | 10 | 2.5 | 23.95 | p2 | 655 | 100
20 | 6.7 |  |  |  | 110 | 34 | 0.3090909091 |  | 20 | -194.12 | 1.18 |  | 300 | 50 | 0.1666666667 | 20 | 5 | 24.9
30 | 10.0 |  |  | 580 | 690 | 49 | 0.08448275862 | 15 | 30 | -191.18 | 1.77 | 560 | 860 | 100 | 0.1785714286 | 30 | 7.5 | 25.85 | m | 0.1098901099
40 | 13.3 |  |  |  |  |  |  |  | 40 | -188.24 | 2.36 |  |  |  |  | 40 | 10 | 26.8
50 | 16.7 |  |  | 0.02586206897 | 0.02586206897 |  |  |  | 50 | -185.3 | 2.95 |  |  |  |  | 50 | 12.5 | 27.75
60 | 20.0 |  |  |  |  |  |  |  | 60 | -182.36 | 3.54 |  |  |  |  | 60 | 15 | 28.7
70 | 23.3 |  |  |  |  |  |  |  | 70 | -179.42 | 4.13 |  |  |  |  | 70 | 17.5 | 29.65
80 | 26.7 |  |  |  |  |  |  |  | 80 | -176.48 | 4.72 |  |  |  |  | 80 | 20 | 30.6
90 | 30.0 |  |  |  |  |  |  |  | 90 | -173.54 | 5.31 |  |  |  |  | 90 | 22.5 | 31.55
100 | 33.3 |  |  |  |  |  |  |  | 100 | -170.6 | 5.9 |  |  |  |  | 100 | 25 | 32.5
110 |  | 33.86 |  |  |  |  |  |  | 110 | -167.66 | 6.49 |  |  |  |  | 110 | 27.5 | 33.45
120 |  | 34.12 |  |  |  |  |  |  | 120 | -164.72 | 7.08 |  |  |  |  | 120 | 30 | 34.4
130 |  | 34.38 |  |  |  |  |  |  | 130 | -161.78 | 7.67 |  |  |  |  | 130 | 32.5 | 35.35
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
940 |  |  | 87.58 |  |  |  |  |  | 940 | 76.36 | 55.46 |  |  |  |  | 940 | 156.98 | 112.3
950 |  |  | 89.15 |  |  |  |  |  | 950 | 79.3 | 56.05 |  |  |  |  | 950 | 158.65 | 113.25
960 |  |  | 90.72 |  |  |  |  |  | 960 | 82.24 | 56.64 |  |  |  |  | 960 | 160.32 | 114.2
970 |  |  | 92.29 |  |  |  |  |  | 970 | 85.18 | 57.23 |  |  |  |  | 970 | 161.99 | 115.15
980 |  |  | 93.86 |  |  |  |  |  | 980 | 88.12 | 57.82 |  |  |  |  | 980 | 163.66 | 116.1
990 |  |  | 95.43 |  |  |  |  |  | 990 | 165.33 | 117.05
1000 |  |  | 97.00 |  |  |  |  |  | 1000 | 167 | 118
1010 |  |  | 98.57 |  |  |  |  |  | 1010 | 168.67 | 118.95
1020 |  |  | 100.14 |  |  |  |  |  | 1020 | 170.34 | 119.9
1024 |  |  | 100.77

Sheet: MapeoIR
BtnOnTV | 0x20DF10EF
BtnOnDeco | 0x10110EF
BtnCanalUpDeco | 0x101926D
BtnCanalDoDeco | 0x10112ED
BtnVolUpDeco | 0x101906F
BtnVolDoDeco | 0x10150AF
DecoBtn0 | 0x1017887
DecoBtn1 | 0x101C03F
DecoBtn2 | 0x101C837
DecoBtn3 | 0x101D827
DecoBtn4 | 0x10120DF
DecoBtn5 | 0x10128D7
DecoBtn6 | 0x10138C7
DecoBtn7 | 0x101A05F
DecoBtn8 | 0x101A857
DecoBtn9 | 0x101B847
DecoBtnOK | 0x101F00F
DecoBtnUp | 0x101609F
DecoBtnDw | 0x101E01F
DecoBtnDe | 0x101E817
DecoBtnIz | 0x101708F
DecoBtnMute | 0x10158A7
DecoBtnGuide | 0x1018877
DecoBtnExit | 0x101E41B

Sheet: ZeroCross
Porcentaje | Valor Byte
10% | 27 | Valor Byte | Porcentaje | 0 | 1 | de | 0 | si max 100 |  | Resp
20% | 24 | 0 |  | 255 |  | hasta | 255 | 0 | 25 | de 0 a 25 | max | mantiene max
30% | 21 | 3 | 90% | 256 | 2 | de | 0 | 25 | 125 | de 25 a Max+25 | --max | llega a 0
40% | 18 | 7 |  | 511 |  | hasta | 255 | 125 | 150 | de max+25 a max+50 | 0 | mantiene 0
50% | 15 | 11 |  | 512 | 3 | de | 0 | 150 | 250 | de max+50 a 2max+50 | ++max | llega a max
60% | 12 | 15 | 50% | 767 |  | hasta | 255 |  | 251 = 0
70% | 9 | 19 |  | 768 | 4 | de | 0
80% | 6 | 23 |  | 1023 |  | hasta | 255
90% | 3 | 27 | 10% | 1024 | 5 | de | 0
100% | 0 | 31 |  | 1279 |  | hasta | 255
0% | 95 | 35 | Apago (34) | 1280 | 6 | de | 0
 |  | 39 |  | 1535 |  | hasta | 255
 |  | 43 | 90% | 1536 |  | vuelve a | 0
 |  | 47
 |  | 51
 |  | 55 | 50%
 |  | 59
 |  | 63
 |  | 67 | 10%
 |  | 71
 |  | 75 | Apago (74)

Sheet: Sensor de Luz 2 (obsoleto)
Momento | Valor | Valor real
Oscuridad total | 181 | 724 | 1 | 724 | 1 | 724 | 1
Umbral Optimo | 80 | 320 | 50 | 320 | 60 | 52 | 94
Tarde adentrada (50%) |  | 0 |  | 52 | 94
Sol total | 13 | 52 | 94

Sheet: Sensores (obsoleto)
 | Luz | V | Fuente | Bateria | °C | Lm35 | Jumper
200 | 100 | 0.5 | 17 | 17 | 158 | 5 | OK | 0
220 | 75 | 1 | 35 | 35 | 165 | 7 | Ausente | >10
280 | 30 | 2 | 73 | 73 | 186 | 17
380 | 10 | 3 | 109 | 109 | 205 | 26
680 | 3 | 3.2 | 117 | 117 | 231 | 38
 |  |  |  |  | 236 | 41
 |  |  |  |  | 247 | 45

Sheet: Menu (obsoleto)
Valor | Vision | EstadoAl (bits) | Alarma | Significado | ConfCas (bits) | Casandra | Significado
0 | Apagado | 1 | Desactivada | Normal - Alarma apagada | 0 | Pasillos | Habilita servicios de pasillo
Hold desde 0 | Casandra HOLA :) | 2 (121) | Activada pasiva 1 | Activa total sin disparar | 1 | Automatico 1 | Habilita automatico 1
1 | Resumen principal | 3 (122) | Activada pasiva 2 | Activa fuera de cuartos sin disparar | 2 | Automatico 2 | Habilita automatico 2
2 | Menu - Activar Alarma | 4 (123) | Activada pasiva 3 | Activa en exterior sin disparar | 3 | Automatico 3 | Habilita automatico 3
3 | Menu - Luces | 5 | Prepanico | Disparada en etapa sin sonido | 4 | Automatico 4 | Habilita automatico 4
4 | Menu - Casandra | 6 | Prepanico | Disparada en etapa sonido intermitente | 5 | Modulo Web | Habilita modulo web
5 | Menu - Grupo automatico | 7 | Panico | Disparo total
6 | Menu - Configuracion | 8 | ¿Armandose? | NC
21 | Alarma - Total
22 | Alarma - Exterior
23 | Alarma - Exterior fuerte |  |  |  | LGrupo (bits) | Grupo | Elementos
31 | Luces - Encender |  |  |  | 0 | Todos | No se usa persé (no se verifica)
32 | Luces - Apagar |  |  |  | 1 | PerimetroJ | Ext Estar - Ext Hall - Gal Pared
33 | Luces - Configurar |  |  |  | 2 | PerimetroF | Perimetro - Porche
41 | Casandra - Servicios + Automatico |  |  |  | 3 | Jardin | Sodio - Ext Hall
42 | Casandra - Solo Servicios |  |  |  | 4 | Auto 1 | Definidos por usuario
43 | Casandra - Solo Automatico |  |  |  | 5 | Auto 2 | Definidos por usuario
44 | Casandra - Apagado |  |  |  | 6 | Auto 3 | Definidos por usuario
51 | Auto - Dias |  |  |  | 7 | Auto 4 | Definidos por usuario
52 | Auto - Banda hs
53 | Auto - Integrantes
61 | Conf - Cambiar Clave
62 | Conf - Cambiar DiaHs
63 | Conf - RESET
64 | Acerca de…
