gonzacarv/Casandra/Docs/Manual/Pantallas.docx

=Valores de Entrada=

(18:1)17:0 18:0 34:1

14:0 13:0 14:1 14:0

41:1 40:0 18:1 40:1

=== Tensiones(V) ===

(R) // (S) // (T)

221v 219v 218v

Bateria: 12.1v

Mie 04 Abr 11:20:14

Temp: 21°C / 18°C

HR: 35% Luz: 20*

Al: Off Act: 12(2)

======= MENU =======

- (1) Alarma

(2) Luces

(3) Casandra

== Max/Min de Lun ==

Maxima: 16°C (01:47)

Minima: 11°C (06:34)

Sol max: 88 (14:05)

== Max/Min de Hoy ==

Maxima: 18°C (00:55)

Minima: 10°C (07:12)

Sol max: 91 (14:23)
