gonzacarv/Casandra/Hard/Hardware/ArduinoSch.PDF

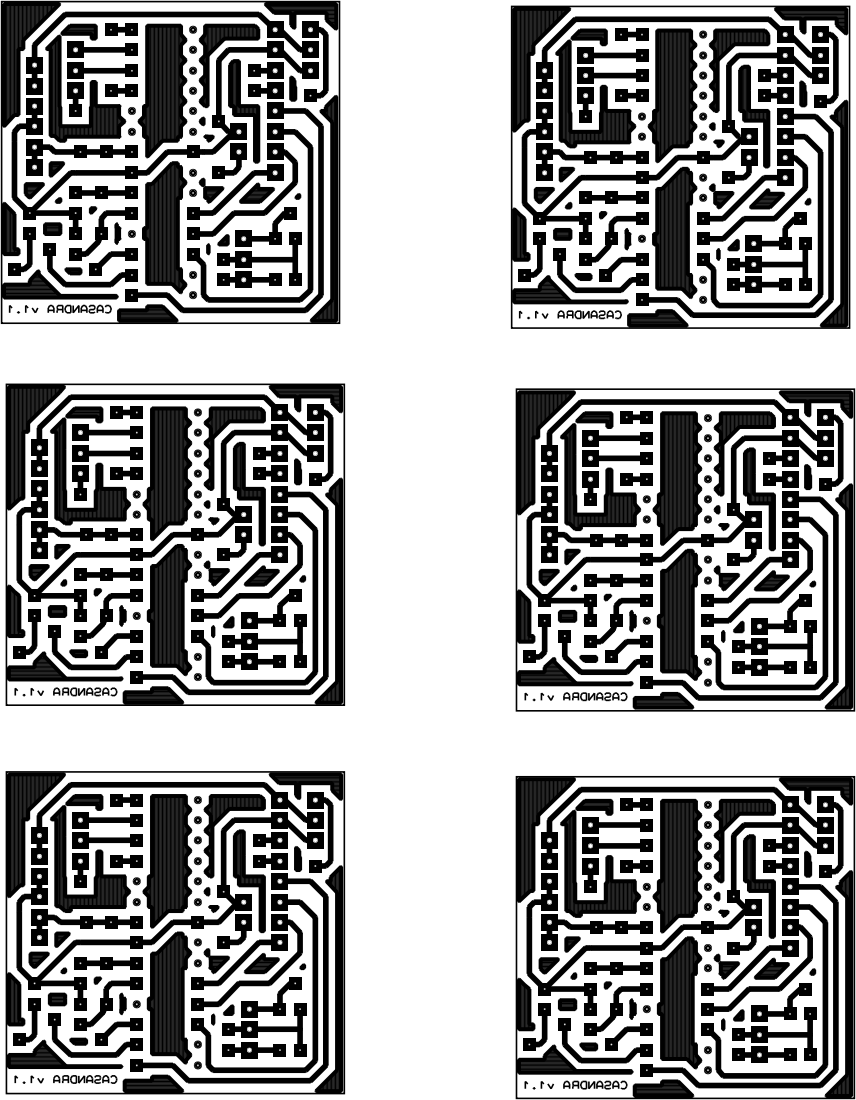
[picture p14: page 1]
