gonzacarv/Casandra/Hard/Hardware/PCB.pdf

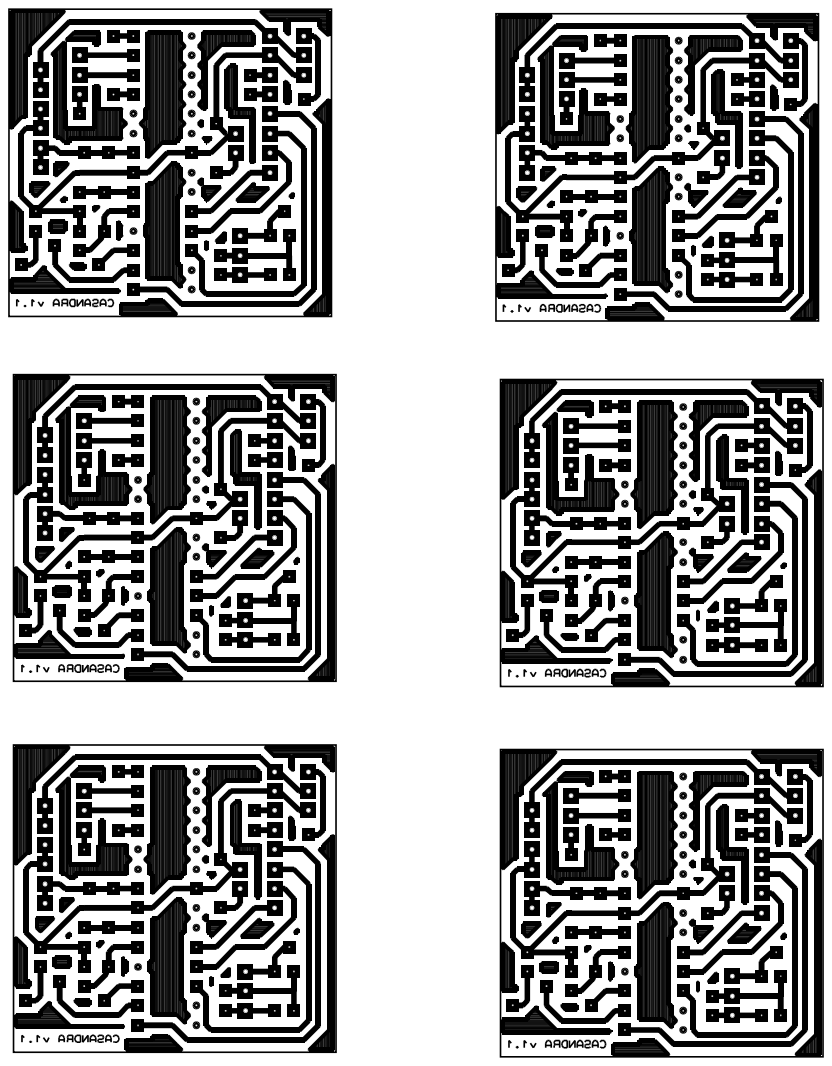
[picture p15: page 1]
