gonzacarv/Casandra/Hard/Actuador Potencia.PDF

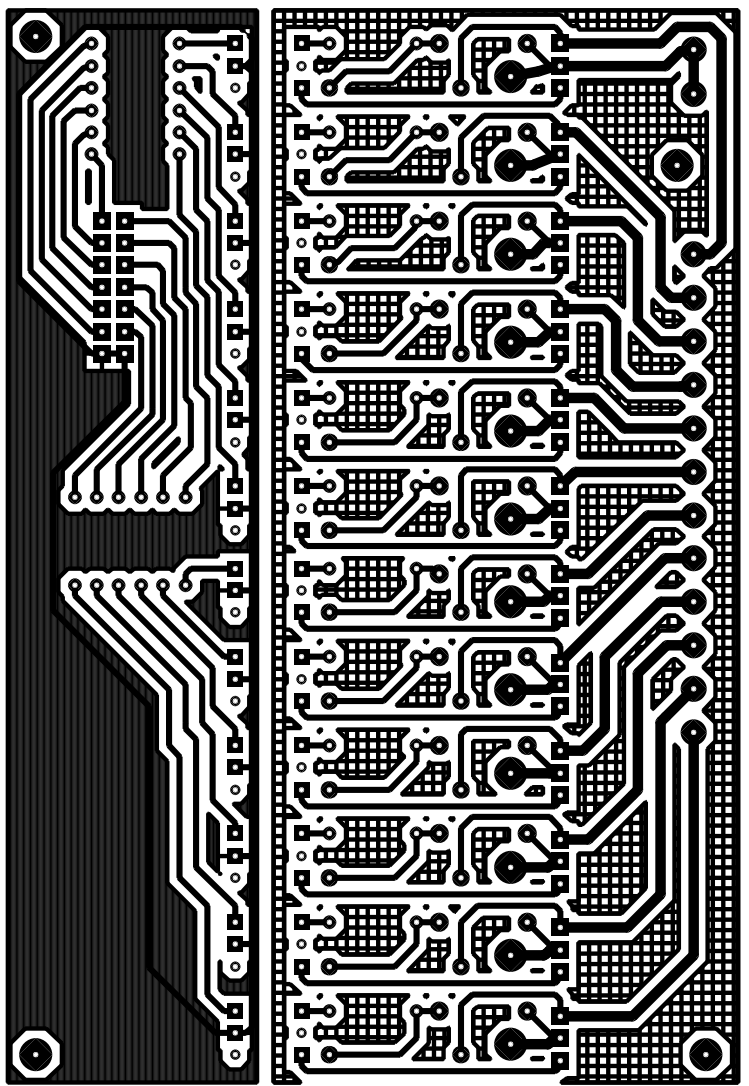
[picture p16: page 1]
