gonzacarv/Casandra/Hard/Impresion Actuadores1.pdf

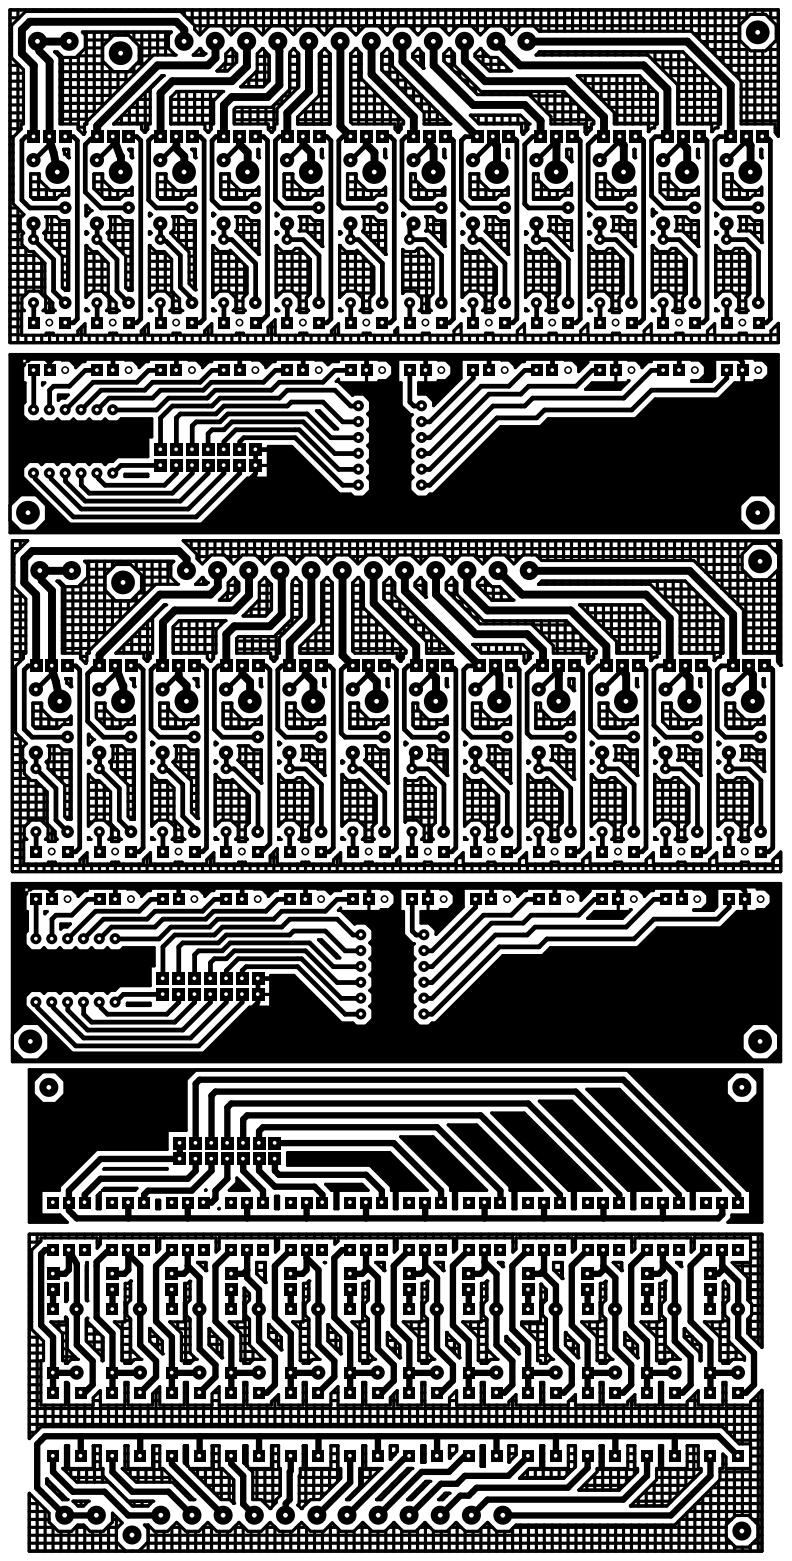
[picture p17: page 1]
