gonzacarv/Casandra/Hard/Impresion Actuadores2.pdf

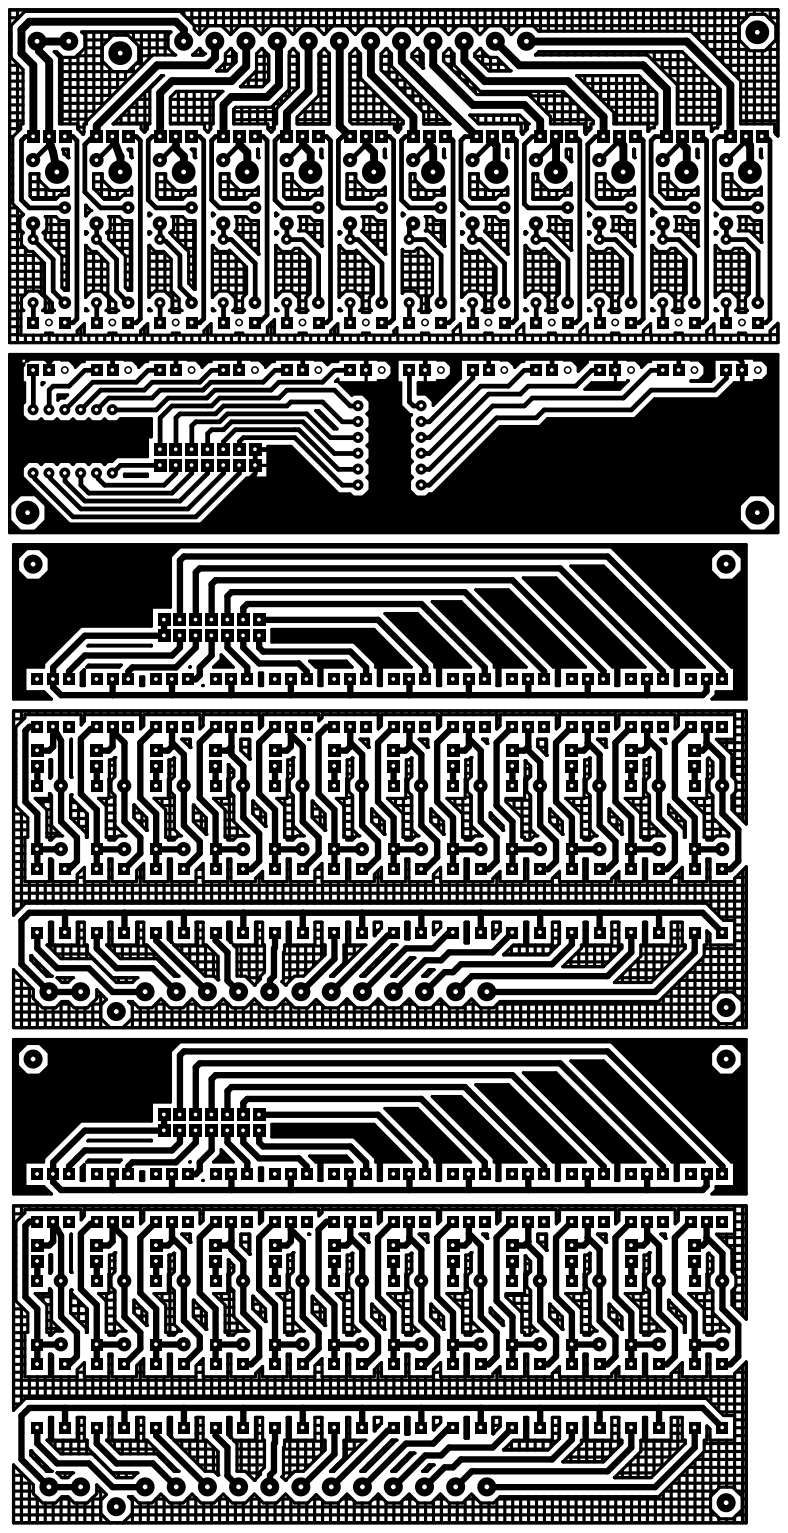
[picture p18: page 1]
