gonzacarv/Casandra/Hard/Impresion Actuadores_Emergencia.pdf

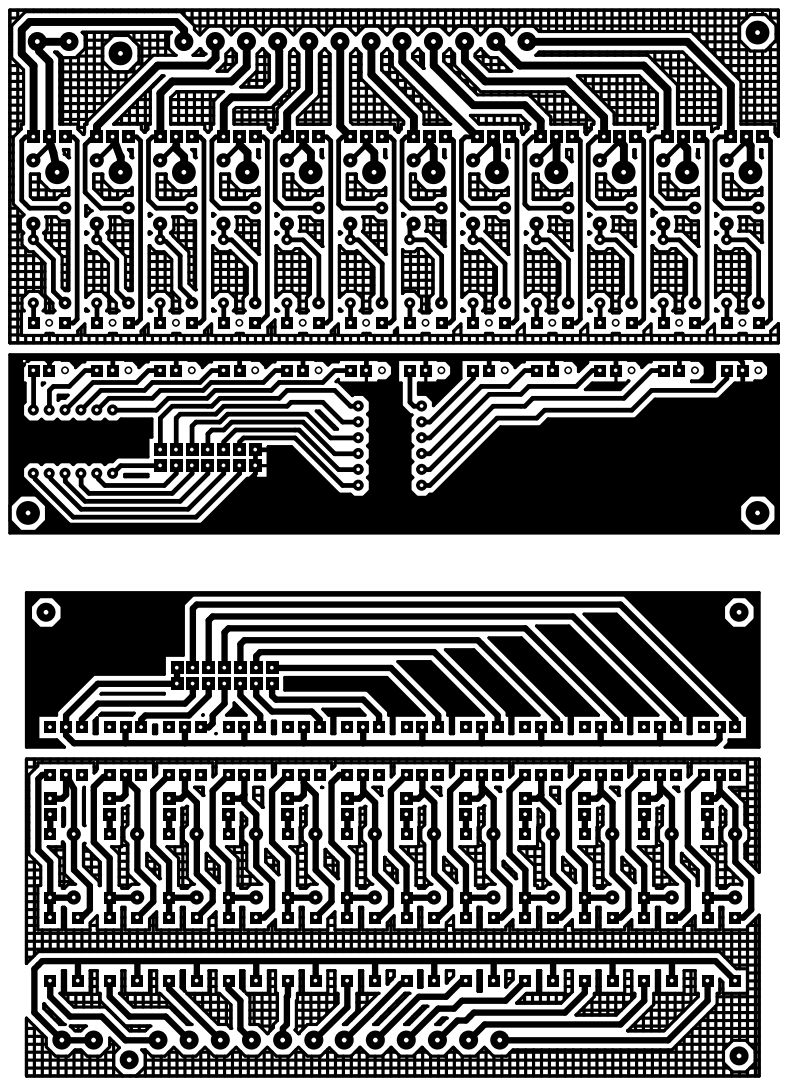
[picture p19: page 1]
