gonzacarv/Casandra/Hard/Luces y Alarma.pdf

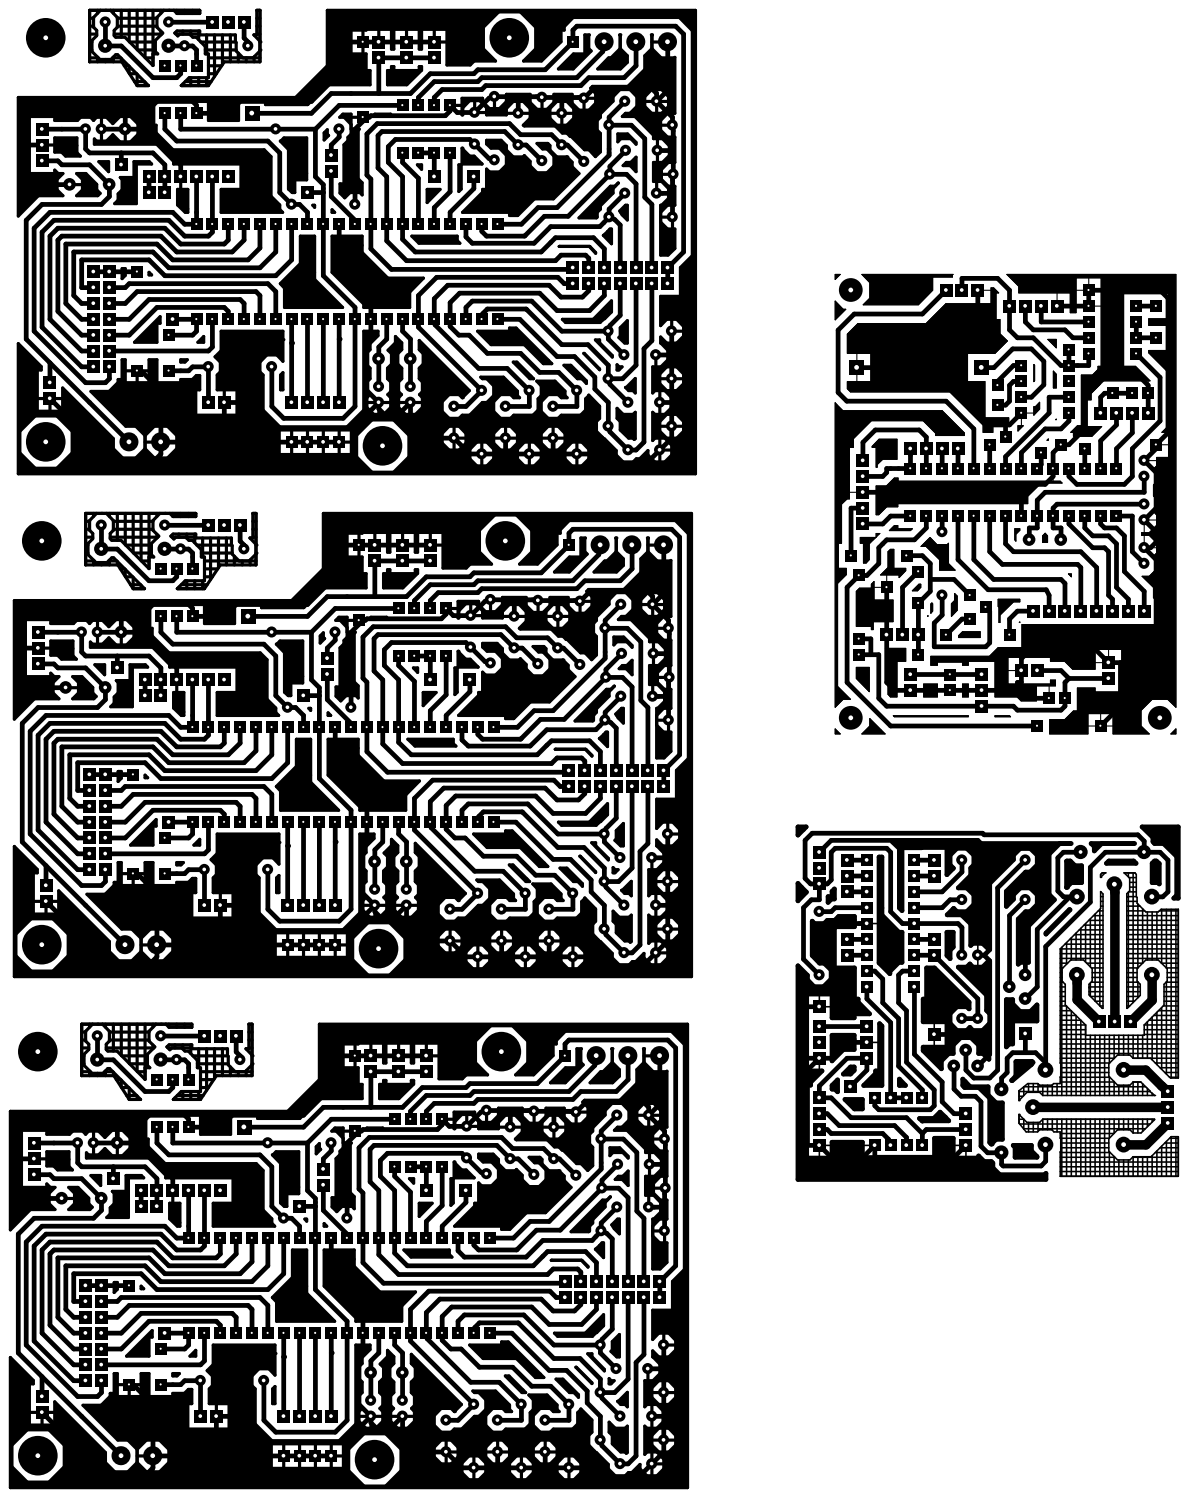
[picture p20: page 1]
