gonzacarv/Casandra/Hard/Luces y RS485.pdf

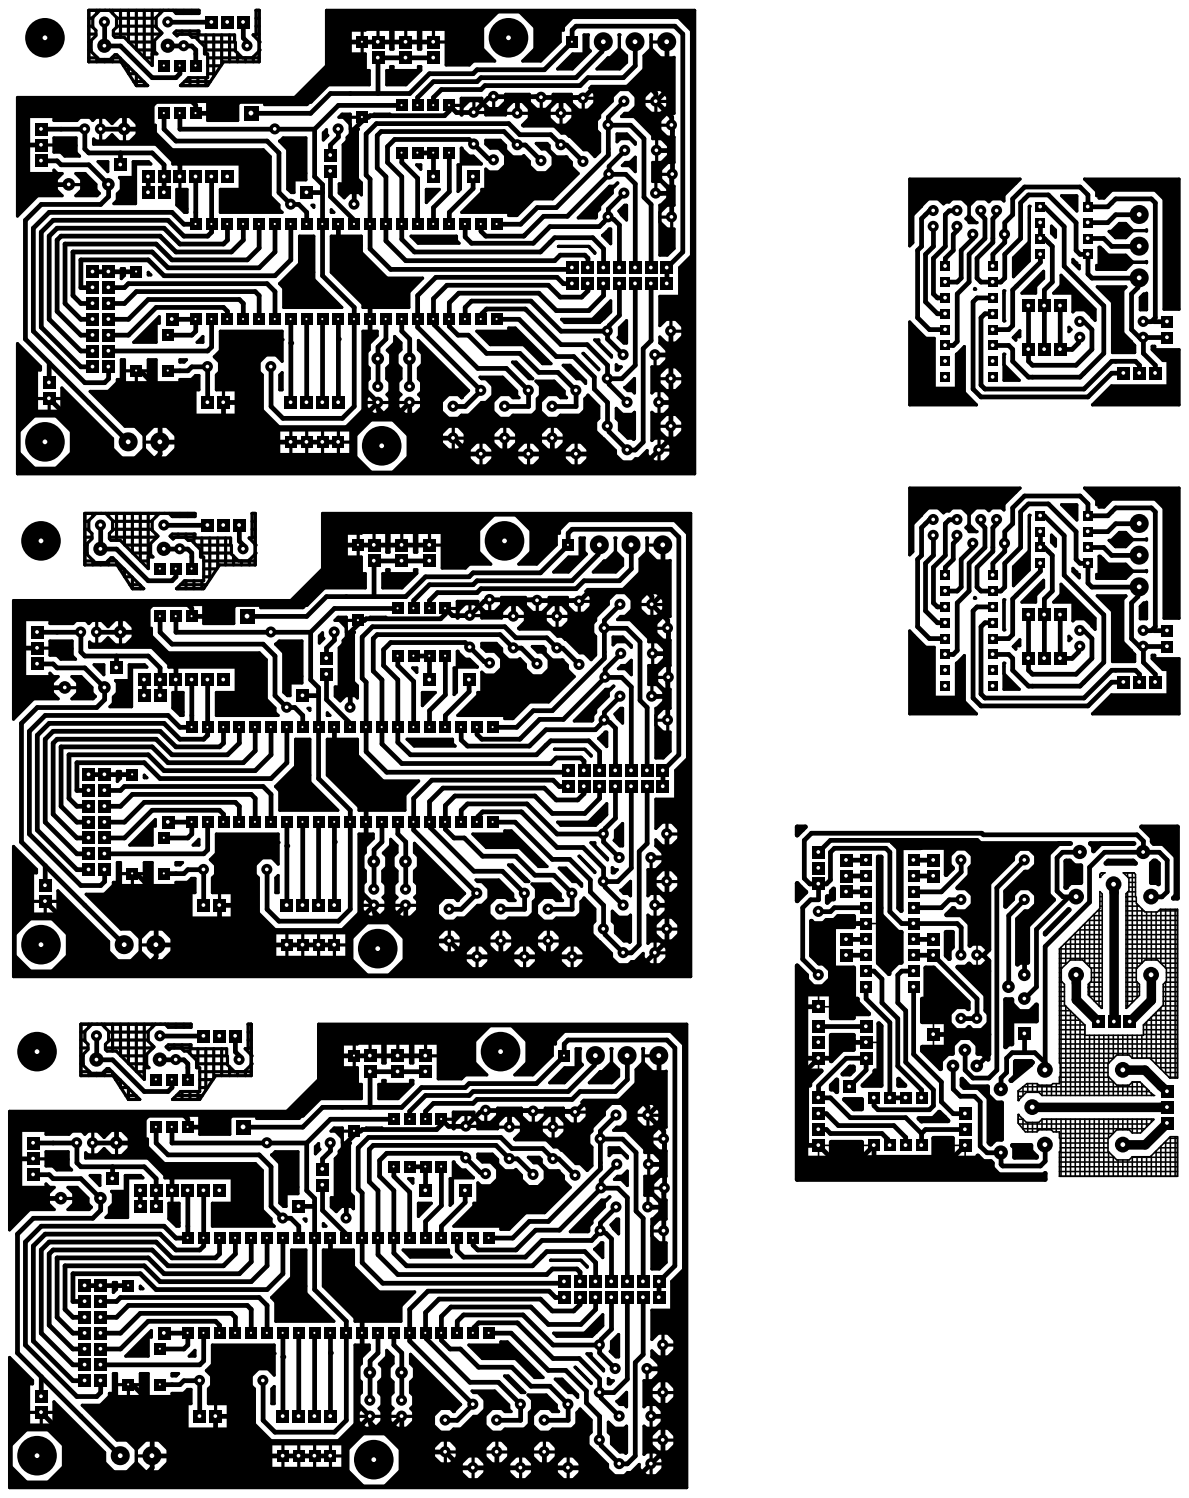
[picture p21: page 1]
