gonzacarv/Casandra/Hard/Actuador Entrada - Salida/Actuador Potencia.PDF

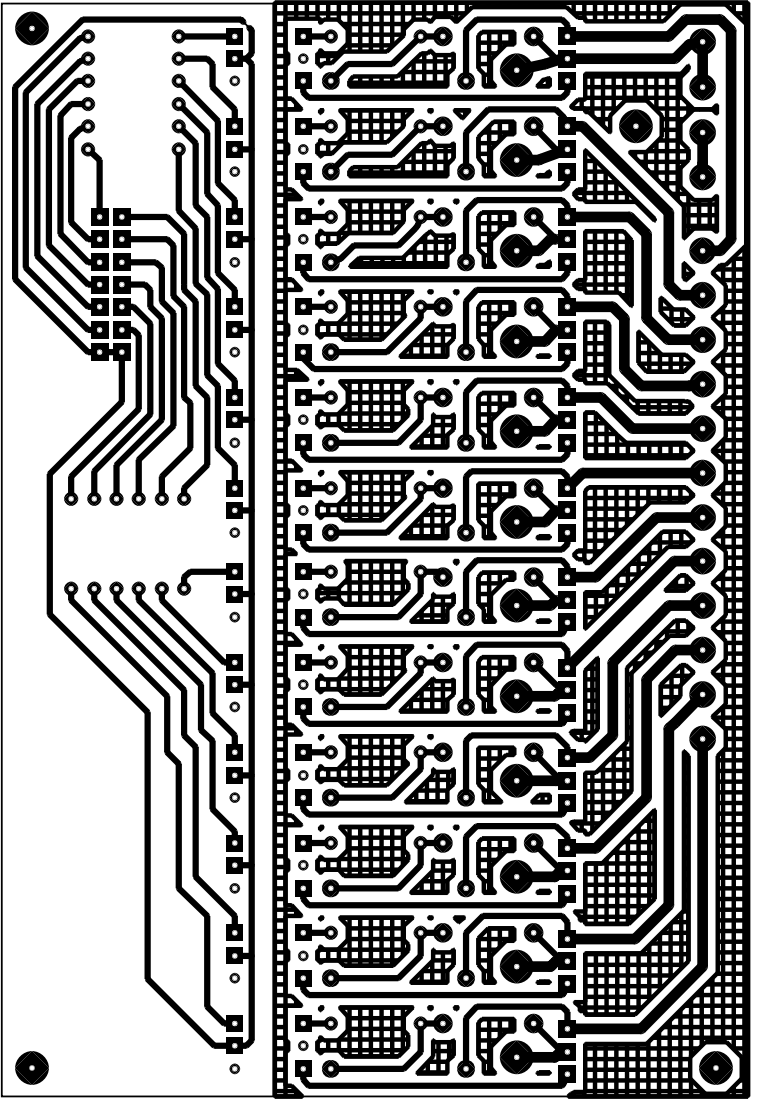
[picture p22: page 1]
