gonzacarv/Casandra/Hard/Actuador Entrada - Salida/Casandra v1.PDF

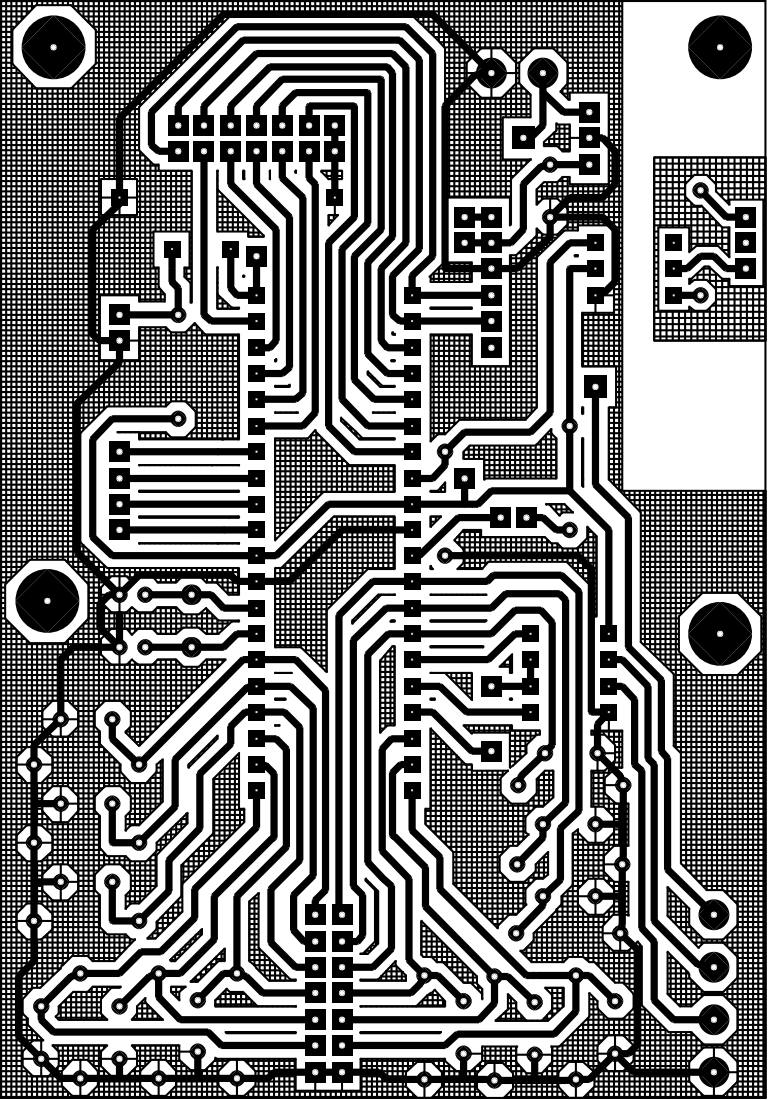
[picture p23: page 1]
