gonzacarv/Casandra/Hard/Alarma/Alarma.PDF

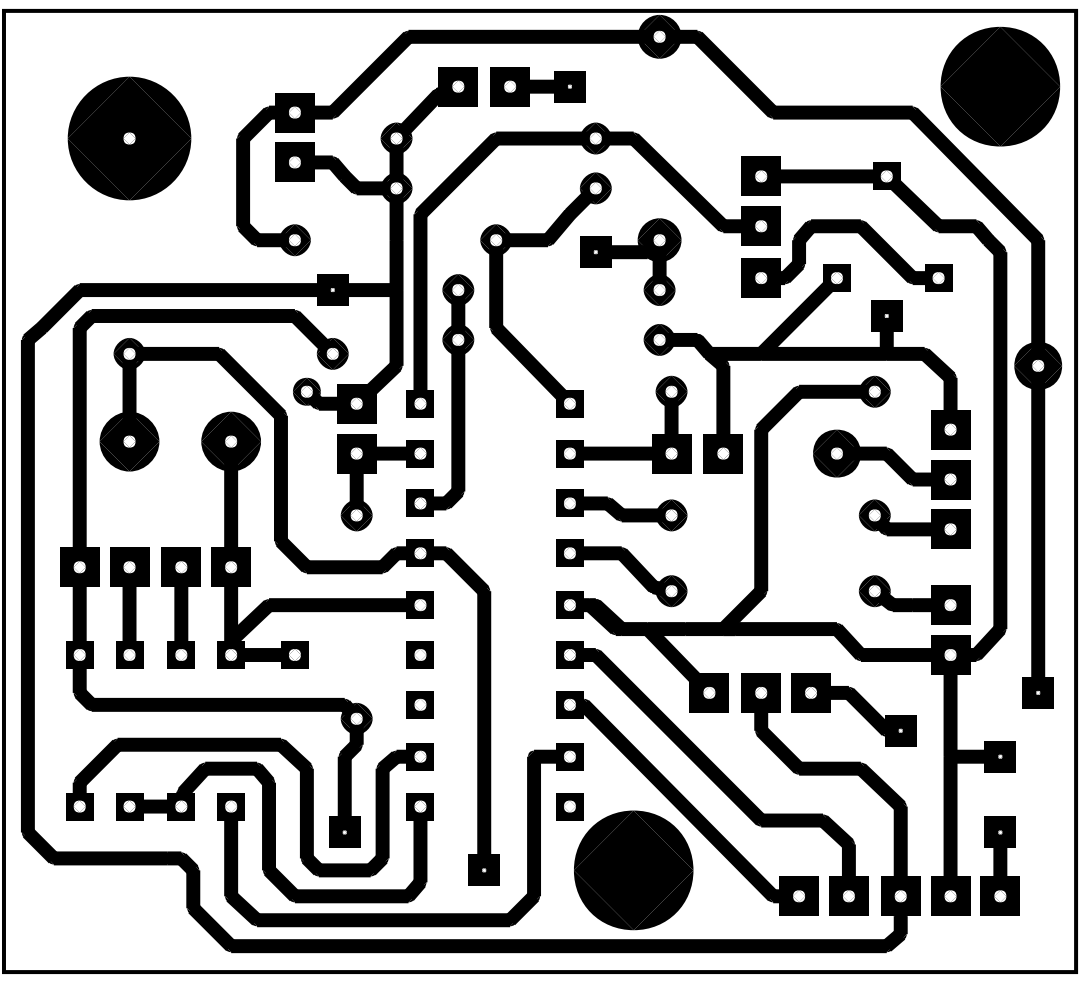
[picture p24: page 1]
