gonzacarv/Casandra/Hard/Control SIM900/Control SIM900.PDF

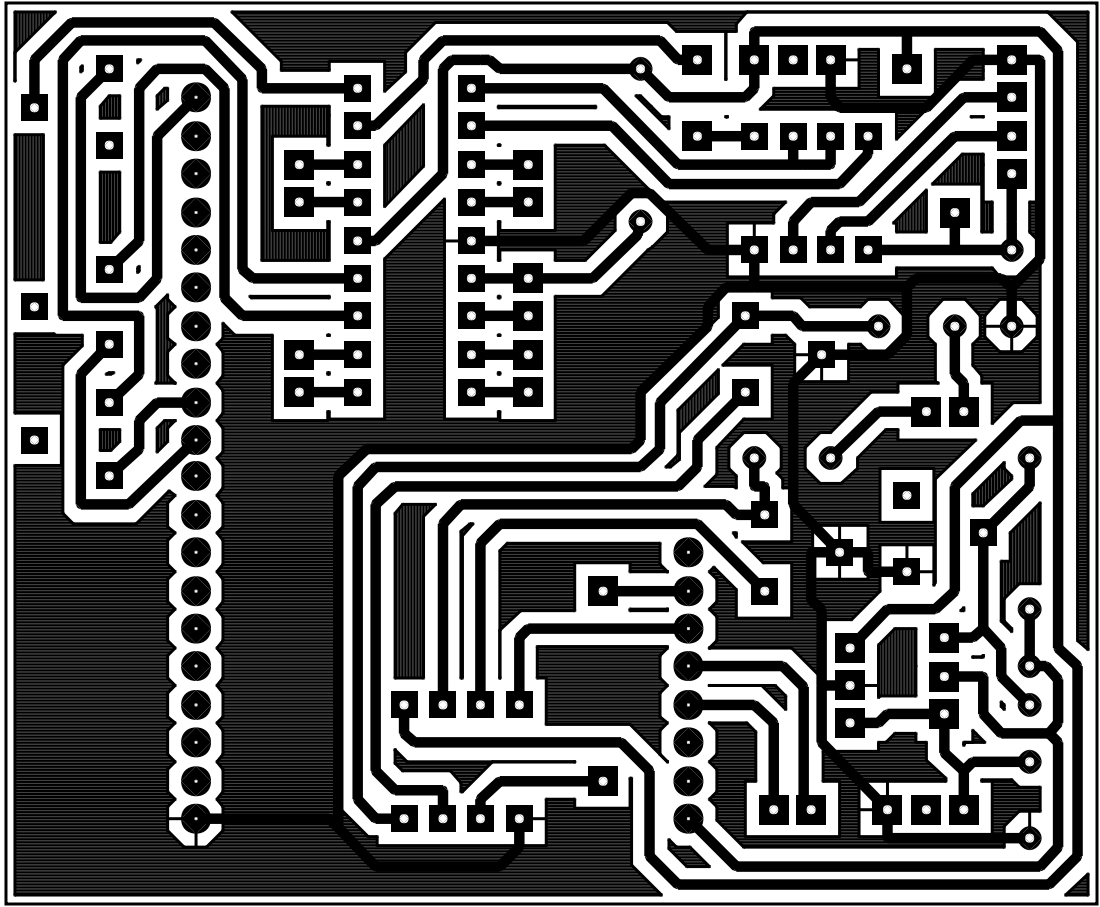
[picture p25: page 1]
