gonzacarv/Casandra/Hard/Entradas/Entradas.PDF

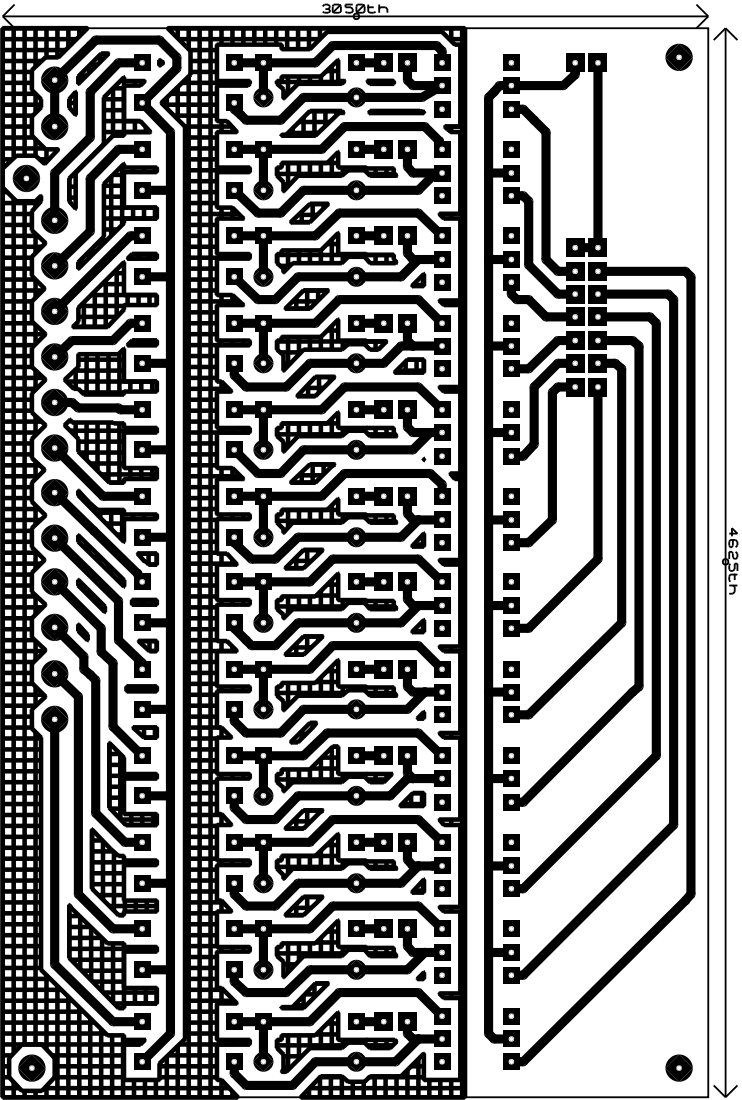
[picture p26: page 1]
