gonzacarv/Casandra/Hard/Estacion MET y Alarma/MET Alarma.PDF

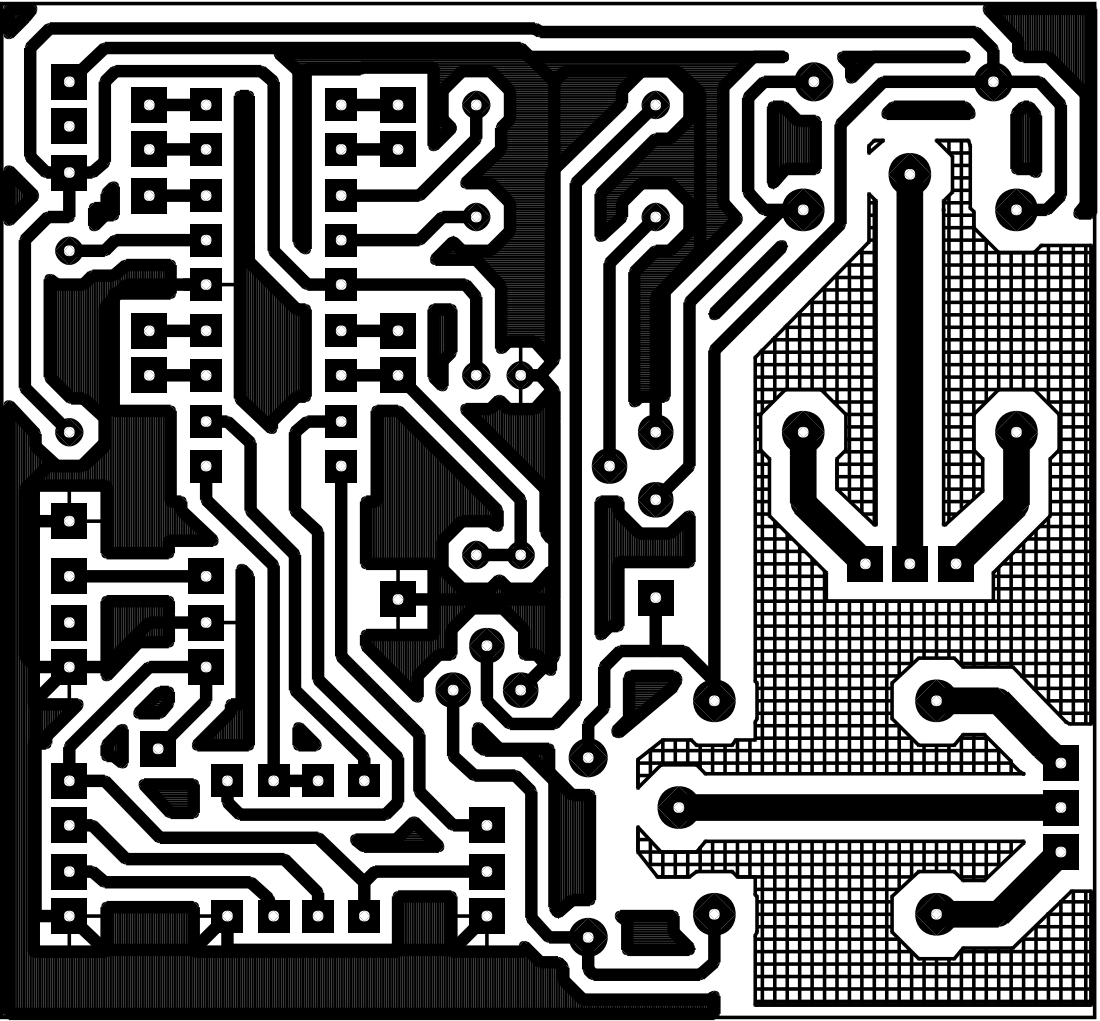
[picture p27: page 1]
