gonzacarv/Casandra/Hard/Estacion MET y LCD/Interface.PDF

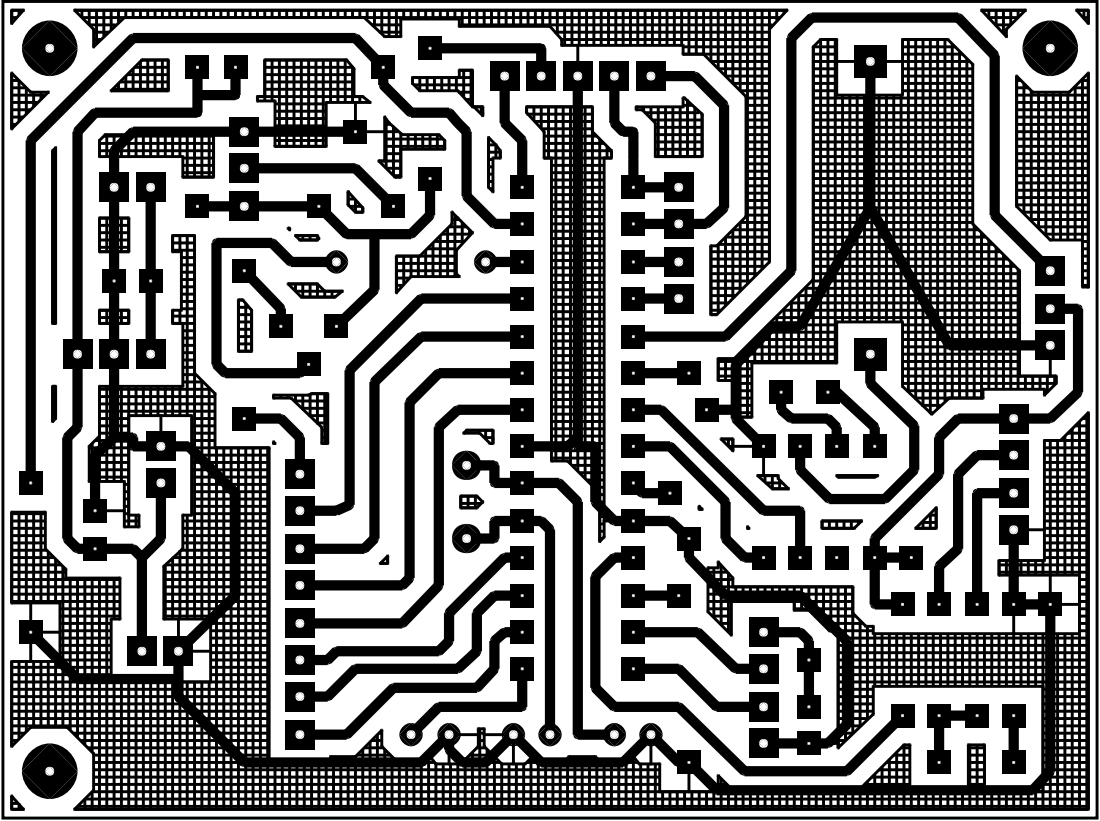
[picture p28: page 1]
