gonzacarv/Casandra/Hard/Teclado/Tactil.PDF

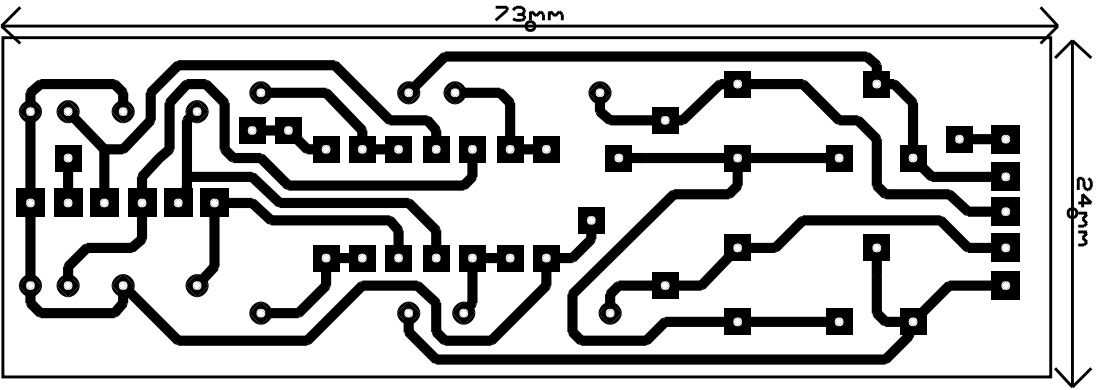
[picture p29: page 1]
