gonzacarv/Casandra/Hard/Actuador Entrada - Salida/v1/Casandra v1.PDF

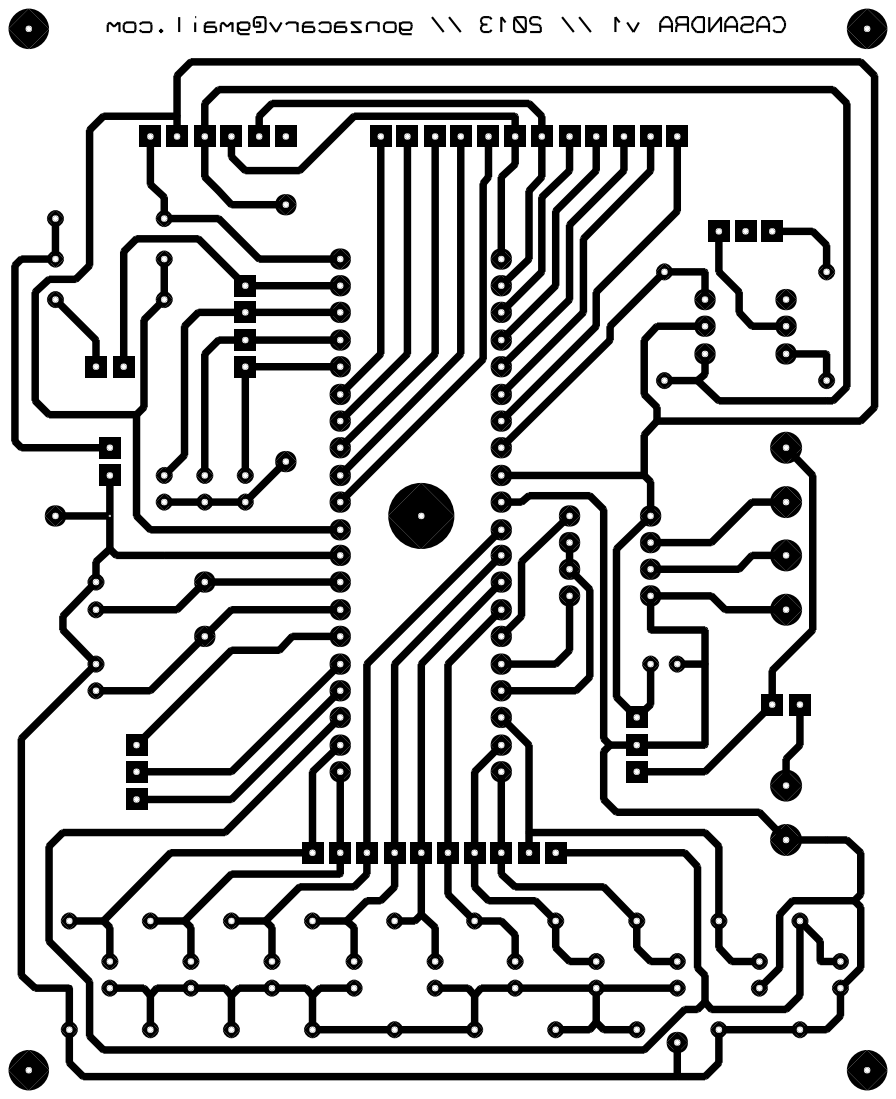
[picture p30: page 1]
