gonzacarv/Casandra/(list of files, drawings)

Other design files:
Hard/Actuador Entrada - Salida/Actuador Potencia.DSN
Hard/Actuador Entrada - Salida/Actuador Potencia.LYT
Hard/Actuador Entrada - Salida/Casandra v1.DSN
Hard/Actuador Entrada - Salida/Casandra v1.LYT
Hard/Actuador Entrada - Salida/Casandra v1.pdsprj
Hard/Actuador Entrada - Salida/v1/Casandra v1.LYT
Hard/Actuador Potencia.LYT
Hard/Alarma.DSN
Hard/Alarma.LYT
Hard/Alarma/Alarma.DSN
Hard/Alarma/Alarma.LYT
Hard/Control SIM900/Control SIM900.DSN
Hard/Control SIM900/Control SIM900.LYT
Hard/Entrada analogica 220/Entrada220.DSN
Hard/Entrada analogica 220/Entrada220.LYT
Hard/Entradas.LYT
Hard/Entradas/Entradas.DSN
Hard/Entradas/Entradas.LYT
Hard/Estacion MET y Alarma/MET Alarma.DSN
Hard/Estacion MET y Alarma/MET Alarma.LYT
Hard/Estacion MET y LCD/Interface.DSN
Hard/Estacion MET y LCD/Interface.LYT
Hard/Hardware/ArduinoSch.DSN
Hard/Hardware/ArduinoSch.LYT
Hard/Luces.LYT
Hard/Master.LYT
Hard/Server v2/Servidor2.DSN
Hard/Server v2/Servidor2.LYT
Hard/Teclado/Tactil.DSN
Hard/Teclado/Tactil.LYT
Hard/Teclado/Teclado.LYT
