gonzacarv/Casandra/Soft/NodeMCU/Casandra_NodeMCU_firmware_v0.1_IRMapper/Casandra_NodeMCU_firmware_v0.1_IRMapper.ino

//Conectado a D1 (IO-5, pin 20) arroja por puerto serial el 0x correspondiente al boton

#include <Arduino.h>
#include <IRremoteESP8266.h>
#include <IRrecv.h>
#include <IRutils.h>

#ifdef ARDUINO_ESP32C3_DEV
const uint16_t kRecvPin = 10;  // 14 on a ESP32-C3 causes a boot loop.
#else  // ARDUINO_ESP32C3_DEV
const uint16_t kRecvPin = D1;
#endif  // ARDUINO_ESP32C3_DEV

IRrecv irrecv(kRecvPin);

decode_results results;

void setup() {
  Serial.begin(115200);
  irrecv.enableIRIn();  // Start the receiver
  while (!Serial)  // Wait for the serial connection to be establised.
    delay(50);
  Serial.println();
  Serial.print("IRrecvDemo is now running and waiting for IR message on Pin ");
  Serial.println(kRecvPin);
}

void loop() {
  if (irrecv.decode(&results)) {
    // print() & println() can't handle printing long longs. (uint64_t)
    serialPrintUint64(results.value, HEX);
    Serial.println("");
    irrecv.resume();  // Receive the next value
  }
  delay(100);
}
