gonzacarv/Casandra/Soft/Atmel/Base Arduino (Webserver)/Test2/Test2.ino

#include <ESP8266WiFi.h>

WiFiServer server(80); //Initialize the server on Port 80

void setup() {

WiFi.mode(WIFI_AP); //Our ESP8266-12E is an AccessPoint
WiFi.softAP("Casandra", "crallova"); // Provide the (SSID, password); .
server.begin(); // Start the HTTP Server


//Looking under the hood
Serial.begin(115200); //Start communication between the ESP8266-12E and the monitor window
IPAddress ip(192, 168, 0, 117); // IP estática
IPAddress gateway(192, 168, 0, 1); // Puerta de enlace
IPAddress subnet(255, 255, 255, 0);// Red

}

void loop() { 

WiFiClient client = server.available();
if (!client) {
return;
}
//Looking under the hood
Serial.println("Somebody has connected :)");
  //Read what the browser has sent into a String class and print the request to the monitor
String request = client.readString();
//Looking under the hood
Serial.println(request);
  }
