gonzacarv/Casandra/(commit log)

2022-05-25 Agrega porton
    [Dimer.xlsx, Esquema red MQTT - Casandra v3.xlsx]
2022-05-28 Porton bug fix
    [Dimer.xlsx]
2022-06-20 v3 - Trein Fix
    [Casandra_NodeMCU_firmware_v0.1_Caldera.ino, Casandra_NodeMCU_firmware_v0.1_Cocina.ino, Casandra_NodeMCU_firmware_v0.1_Cuartos.ino, Casandra_NodeMCU_firmware_v0.1_Galeria.ino, Casandra_NodeMCU_firmware_v0.1_Porton.ino]
2022-08-12 v6 (RGB + IRBlast)
    [Dimer.xlsx]
2022-08-13 v6 (IR FullMap)
    [Dimer.xlsx]
2022-08-20 v6.1 (Curva22)
    [Dimer.xlsx]
2022-08-22 v6.2 (RGBOff)
    [Dimer.xlsx]
2022-08-27 v6.3 (PuertaLogi)
    [Dimer.xlsx]
2022-10-16 v7.1 (BoolDebug)
    [Dimer.xlsx]
2022-11-28 v7.5 (HidroCtrl)
    [Dimer.xlsx]
2023-01-01 NewServer v1.1 - v8.1 (Chacruntu)
    [Dimer.xlsx]
2023-01-12 CocinaBis + Huerta v2
    [Dimer.xlsx]
2023-01-12 LED CocinaB fix v1
    [Dimer.xlsx]
